MakerSeldon/SimpleOpenVentilator/System/ElectoMechanicalControlSystem/README.md

## **Electromechanical Control systems**

The System is driven by a very simple control system.

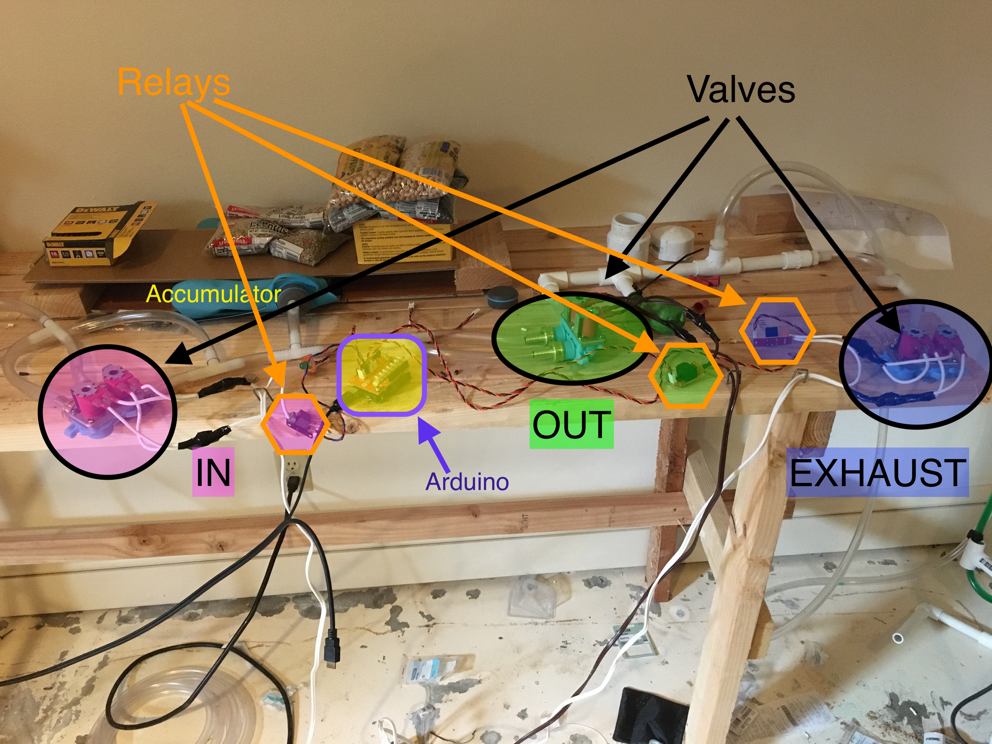
[picture p4: System/ElectoMechanicalControlSystem/AsBuilt.jpg]
As Built


### Mechanical
3 Valves

### Electrical
1 arudino uno
3 relays

---------------

### Current State:
Control circuit timing is fixed currently. Can be changed by uploading new code with updated constants

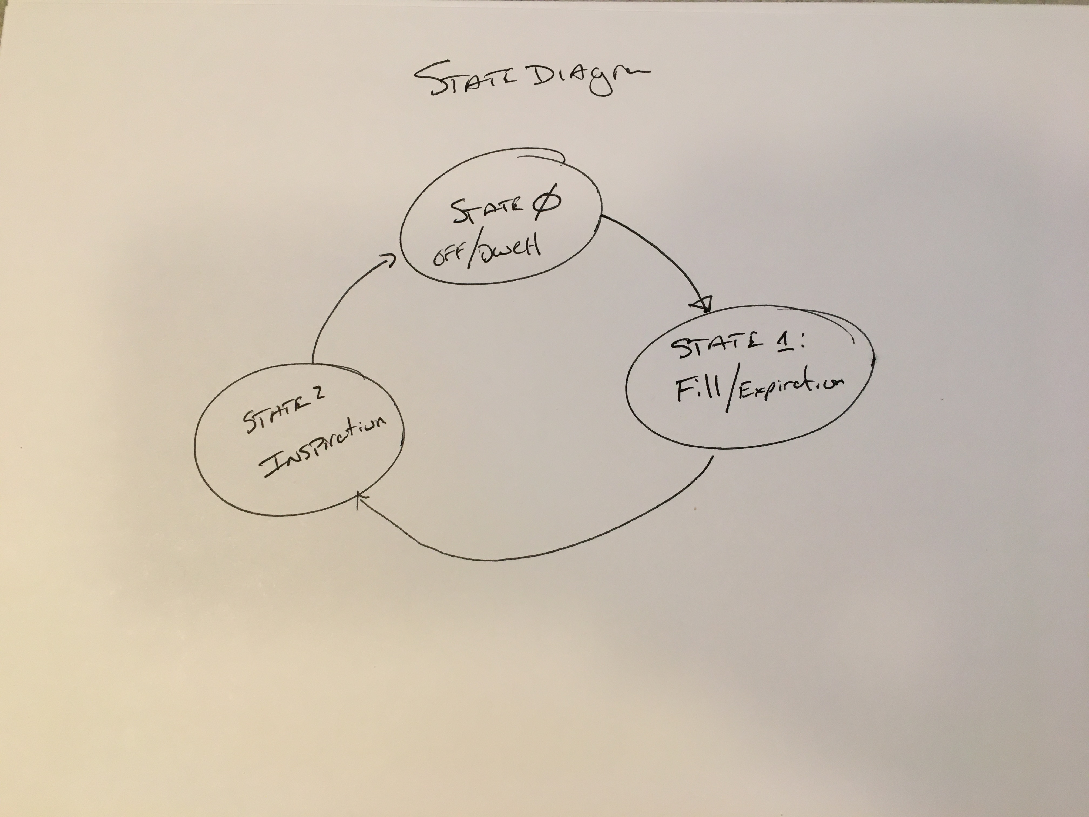
[picture p5: System/ElectoMechanicalControlSystem/StateDiagram.jpg]
State Diagram


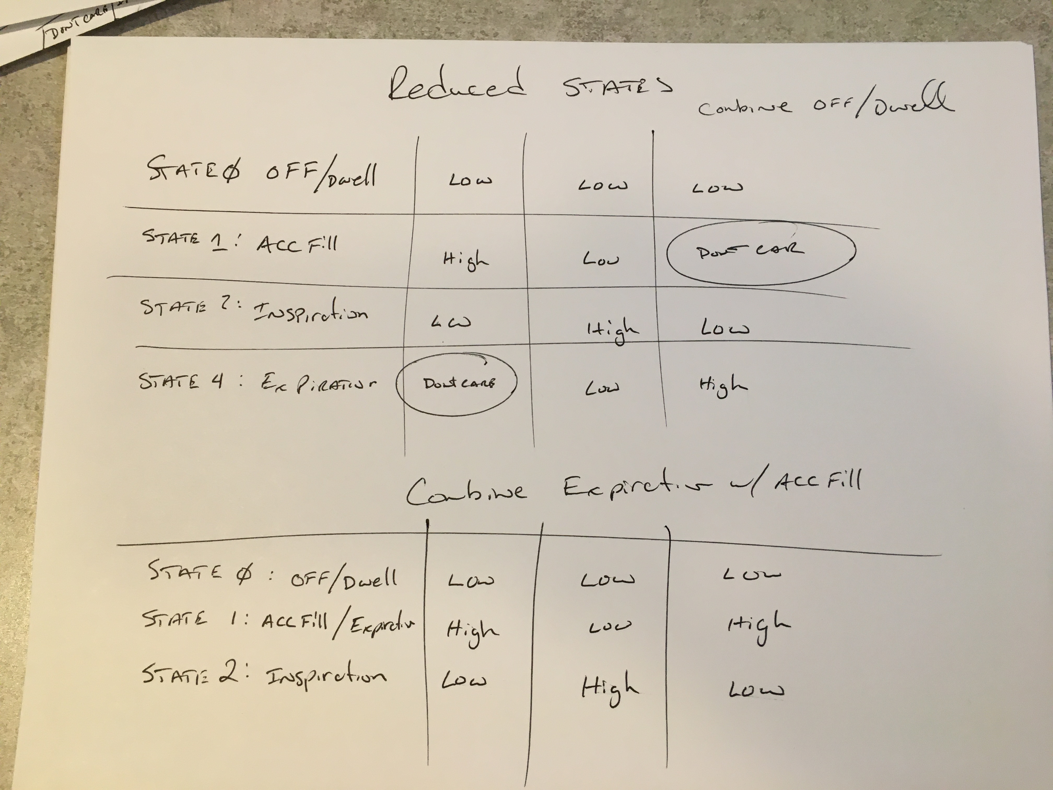
[picture p6: System/ElectoMechanicalControlSystem/Refined_page2.jpg]
State Variable Chart


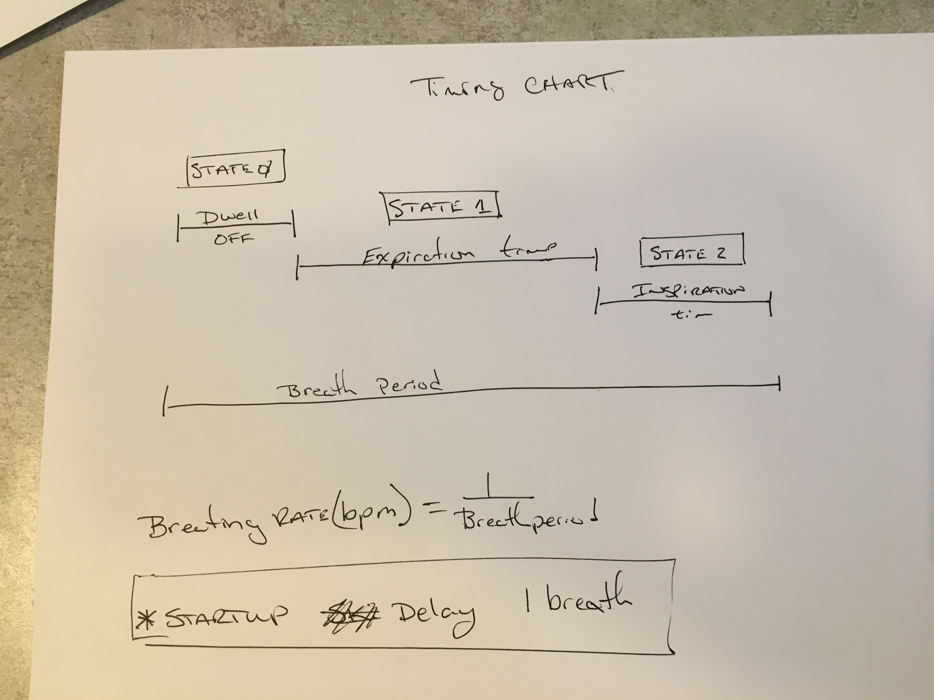
[picture p7: System/ElectoMechanicalControlSystem/TimingChart.jpg]
Timing Chart


### TODO:

* Add 2 Potentiometer inputs to vary Pulse width and Period
* Add display showing timing for each
* Add safety stops for out of bounds
