MakerSeldon/SimpleOpenVentilator/System/AirDistrubution/README.md

## Air Distribution

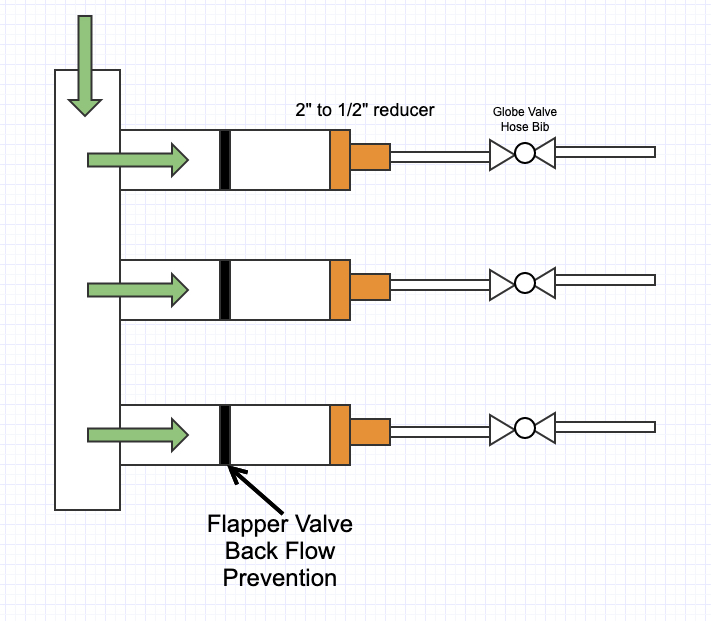
[picture p8: System/AirDistrubution/AirDistribution.jpg]
Distribution


**TODO: Pictures,Assembly Instructions**
