MakerSeldon/SimpleOpenVentilator/System/AmbuBag/README.md

## Ambu+ Bag

An Ambu+ bag or equivalent is a human powered ventilator. The device has multiple
safety features, valves, volume, and pressure check in it. Below is a drawing
of one reverse engineered. This was from the one we had in lab.

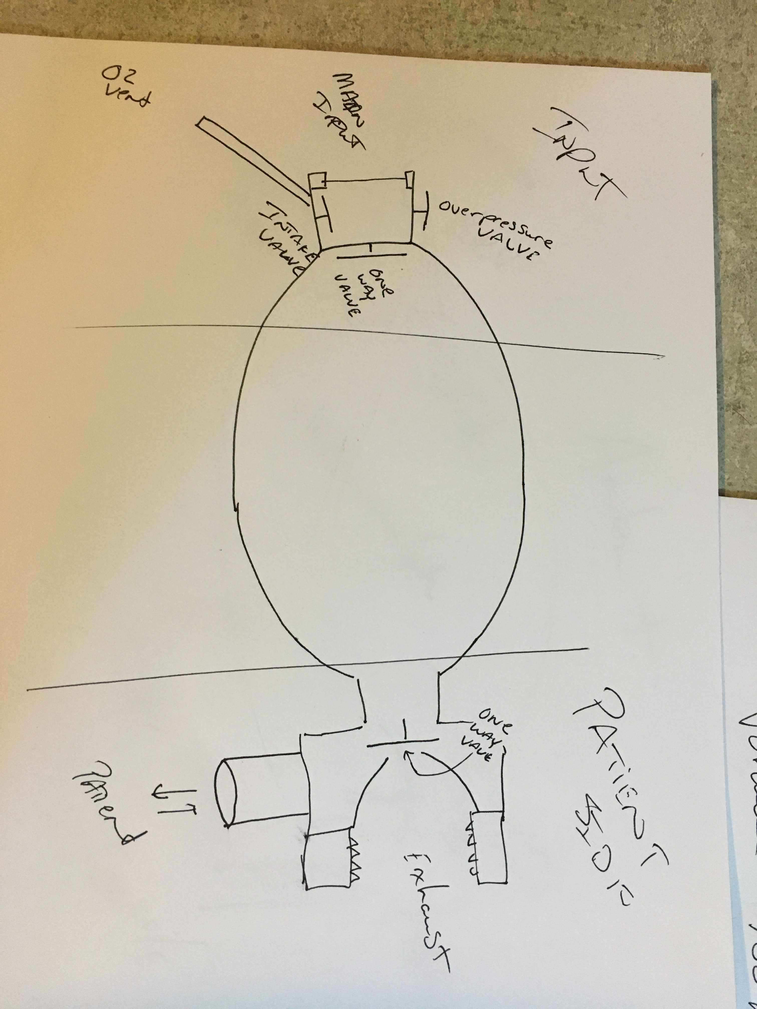
[picture p14: System/AmbuBag/ambubagdrawing.jpg]
AmbuBag
