MakerSeldon/SimpleOpenVentilator/System/LowPressureManometer/README.md

## Low Pressure Manometer

Having a means of reliably measuring pressure is critical to the performance of any ventilator. The readily available pressure gauges are typically designed for tire pressures 15-100psi. We are concerned with slightly negative pressure or slightly positive. The medical field measures in mmHg. We don't have that readily available, but we do have water available.

### Design Drawing
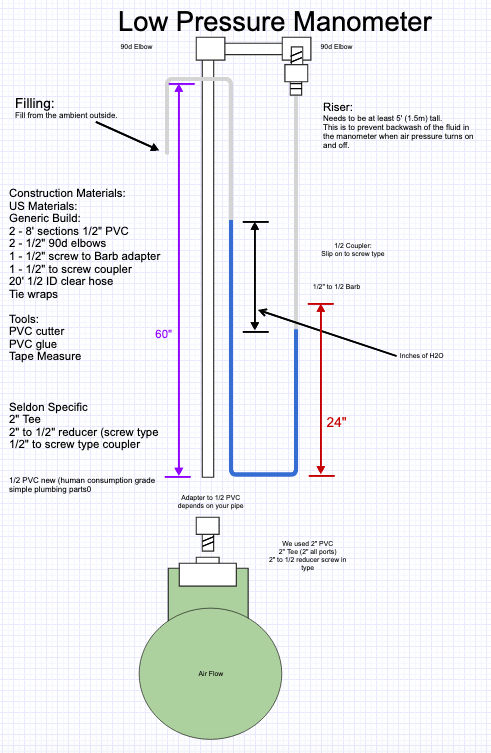
[picture p15: System/LowPressureManometer/manometerDrawing3.jpg]
Simplified


### Images
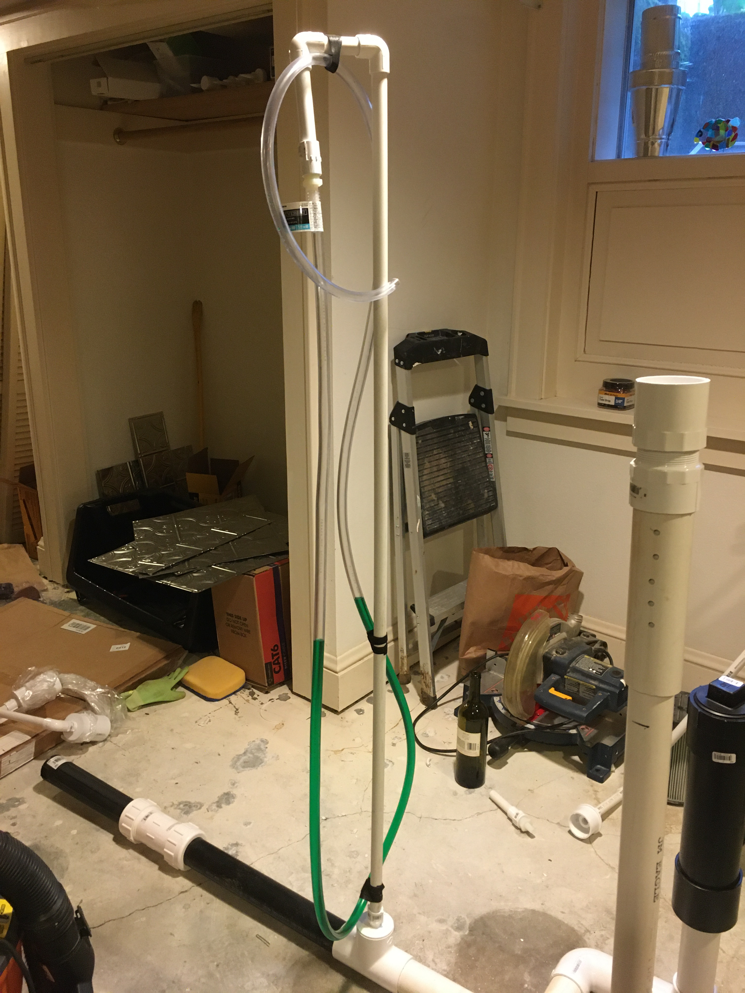
[picture p16: System/LowPressureManometer/ManometerSide.jpg]
Side View Green Food Coloring

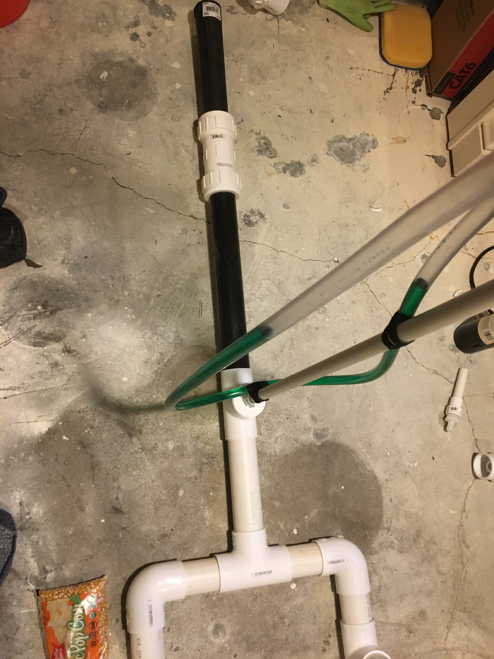
[picture p17: System/LowPressureManometer/ManometerConnect.jpg]
How to connect

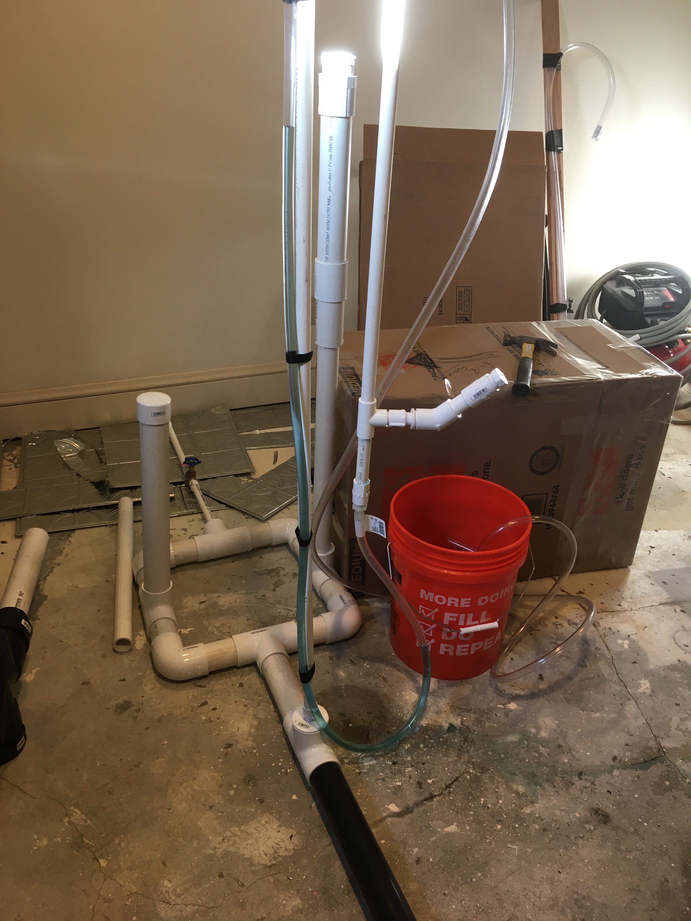
[picture p18: System/LowPressureManometer/manometer_success.jpg]
Working Manometer

Measured 39" of pressure..

### Lessons Learned
It is relatively easy to make a manometer, clear tubing and some water, but as I learned keeping the water out of the flow and in the tube is easy, but takes a bit of ingenuity. Mostly it just takes height.
