MakerSeldon/SimpleOpenVentilator/System/PressureRelief/README.md

## Pressure Relief Valve
Basic gravity pressure relief valve. When overpressure occurs, the lid tilts knocking the weight off and opening the line to ambient air. Valve tilted at a 10degree angle to ensure proper operation.

**TODO: Document and Test**

### Version 2
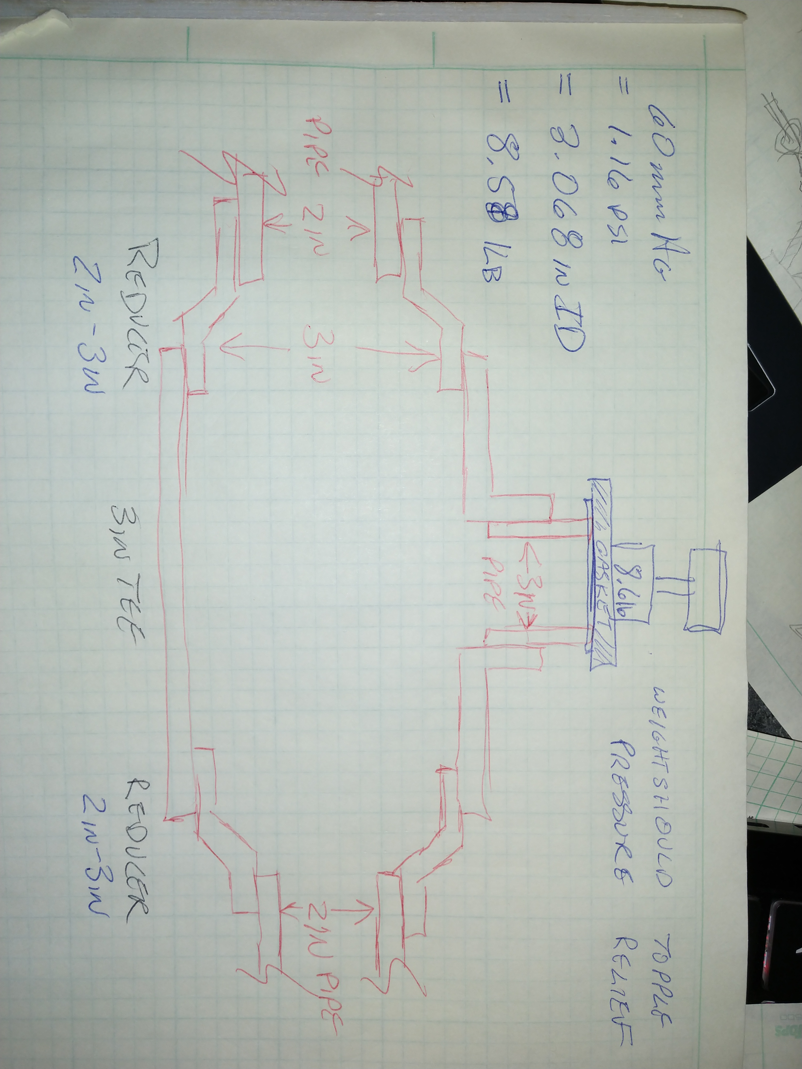
[picture p21: System/RawDesigns/PRV_sketch.jpg]
As Sketched

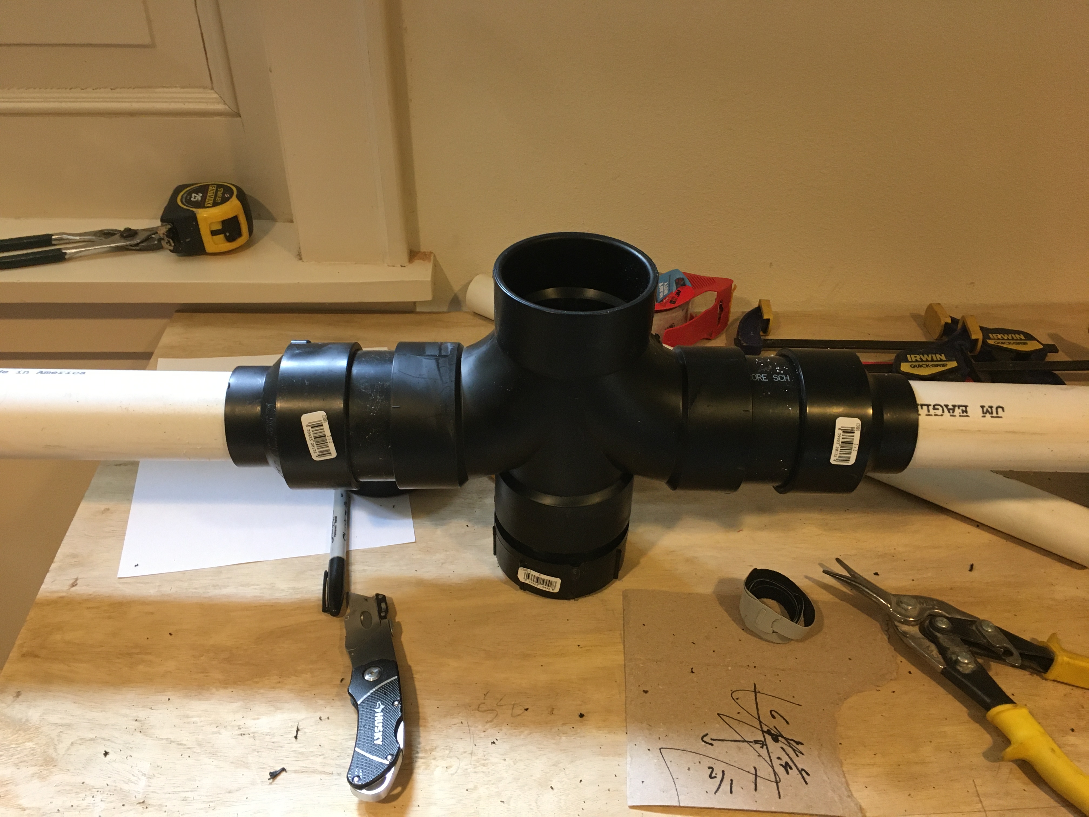
[picture p22: System/Images/PRV_built.jpg]
As Built


### Version 1
OBE
