MakerSeldon/SimpleOpenVentilator/System/AirDistrubution/BackflowValve/README.md

### Backflow Control Valve

Description from ____

Ping pong ball 1.57" diameter
Upward facing 2" to 1.5" reducer (funnel shaped)

1.5" section of pipe
2.0" section of pipe
reduce down to 1/2" for hose bib

Note: This is gravity and has to face up so the ball rolls into the pipe
