MakerSeldon/SimpleOpenVentilator/System/AirFilter/v1/README.md

# Experiment 1:
Can we build a box that can filter the air from a shop vac from Home Depot
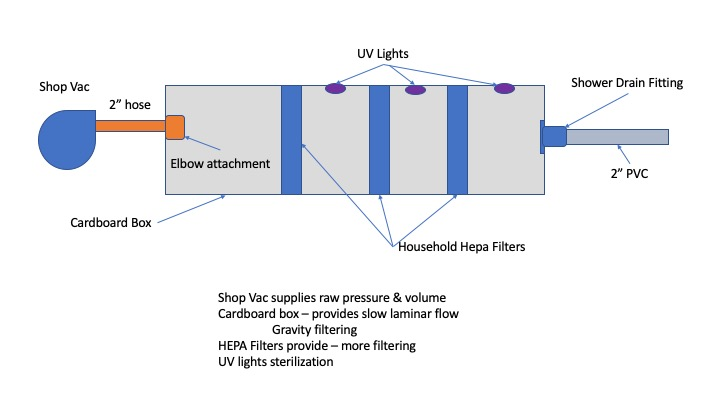
[picture p26: System/AirFilter/v1/AirflowBox.jpg]
Airflow Box

---------
# Hypothesis 1:
We can build a box that will provide laminar flow through the volume so gravity can filter larger particles, and HEPA / nice filters can do the job

## Build - 1
Single Stage Filter box

Shop vac input -- box -- 16x20x4 filter -- box -- 2" output
* AirBoxExperiment_1.jpg shows supplies used
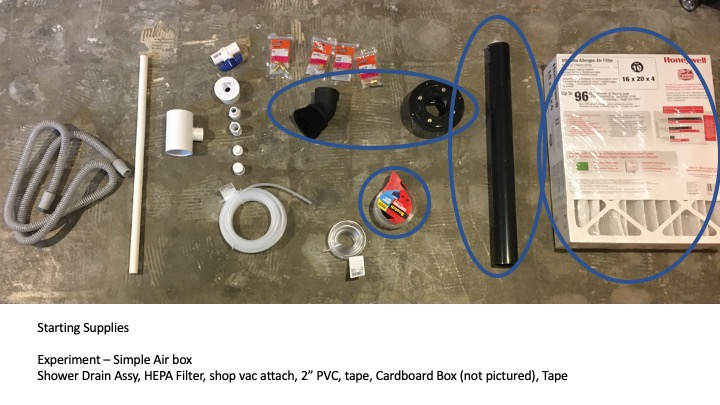
[picture p27: System/AirFilter/v1/AirBoxExperiment_1.jpg]
Parts used
  
* FilterInstall.jpg shows putting the filter in the middle of two boxes
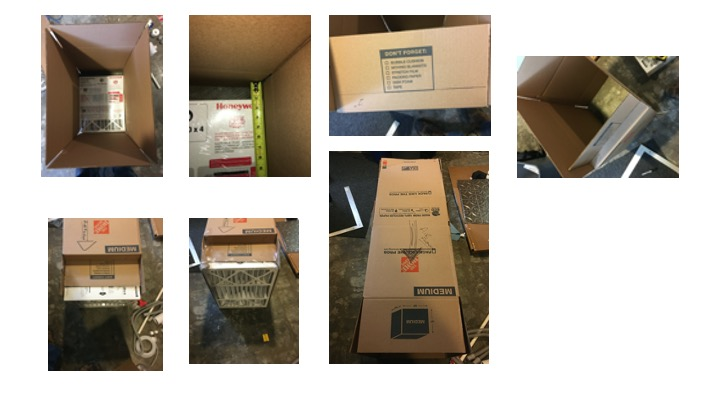
[picture p28: System/AirFilter/v1/FilterInstall.jpg]
Installing the filter
  
* Input/Output.jpg shows installing the in/out fittings.
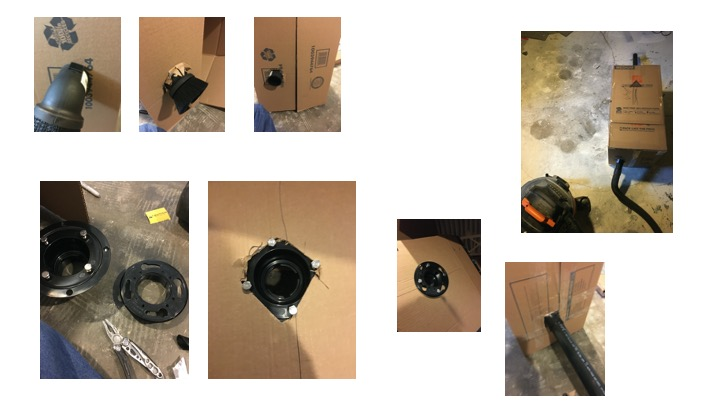
[picture p29: System/AirFilter/v1/InputOutput.jpg]
Final Assembly of single stage
  

Functionally tested system Air blows through fine -- no significant pitch change in shop vac. Shop vac has filter and bag installed.

# Hypothesis 2:
Shop Vac can push enough air through filter-box without loading the vac significantly.
## Results:
* Initial results positive, not change in sound from shop vac.
* TODO: measure pressure drop across box.
* Initial output pressure 0.5"water on the manometer
* Tested direct output of ShopVac Blew water out 3' 5/8ID hose

# RESULTS: **NEGATIVE** Box leaked way too much air.  Need to try again with a crate

## Build - 2
Build simple manometer for input and output
