MakerSeldon/SimpleOpenVentilator/System/Diagrams/README.md

## Adding and testing clarity of diagrams

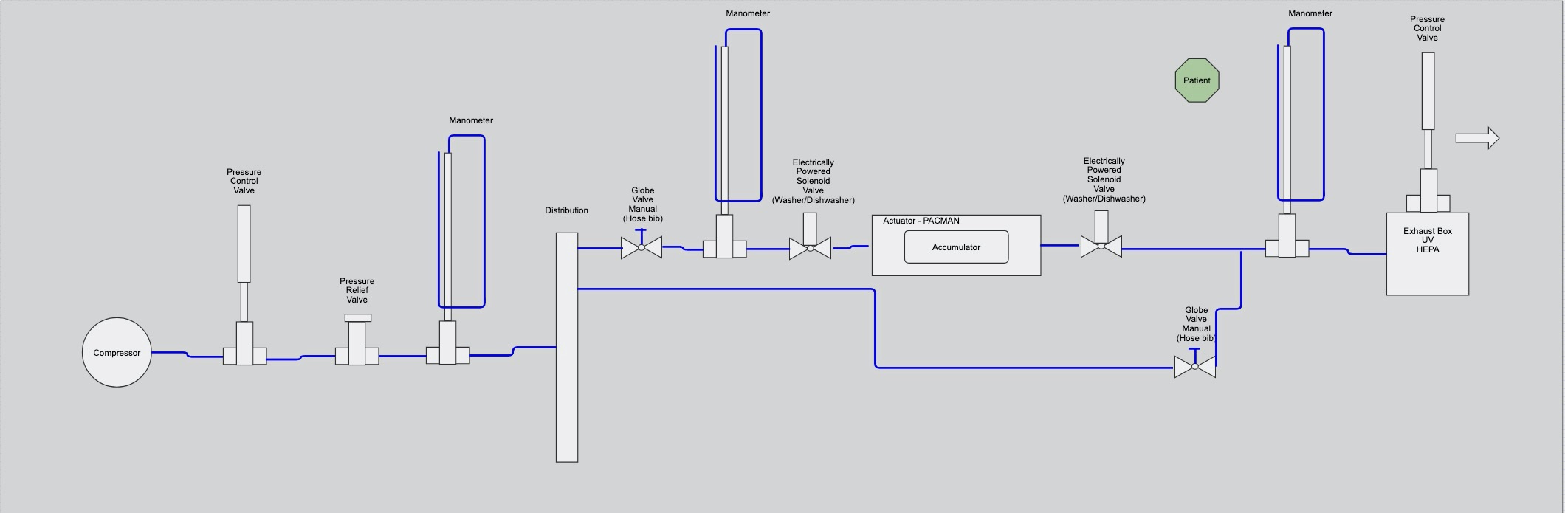
[picture p32: System/Diagrams/PipeView.jpg]
Diagram 1

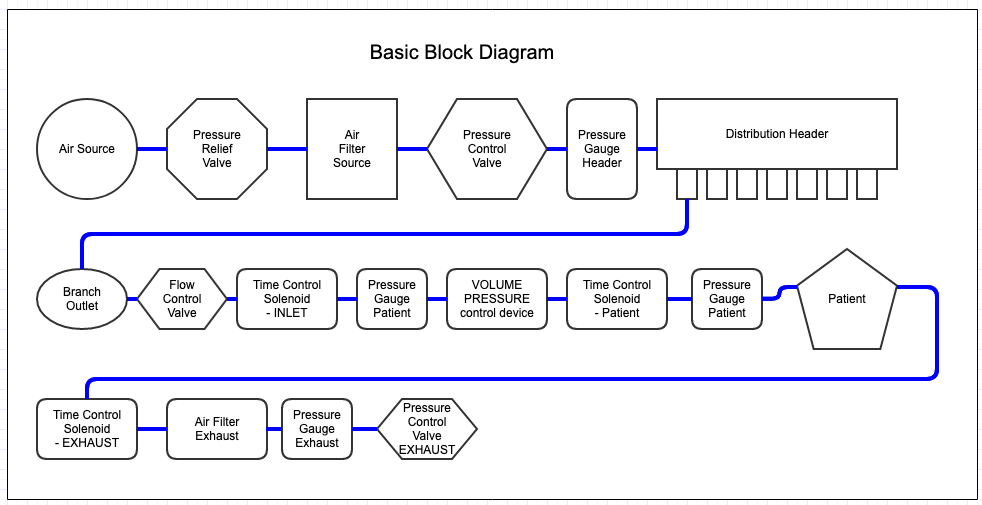
[picture p33: System/Diagrams/BlockDiagramv1.1.png]
Block Diagram

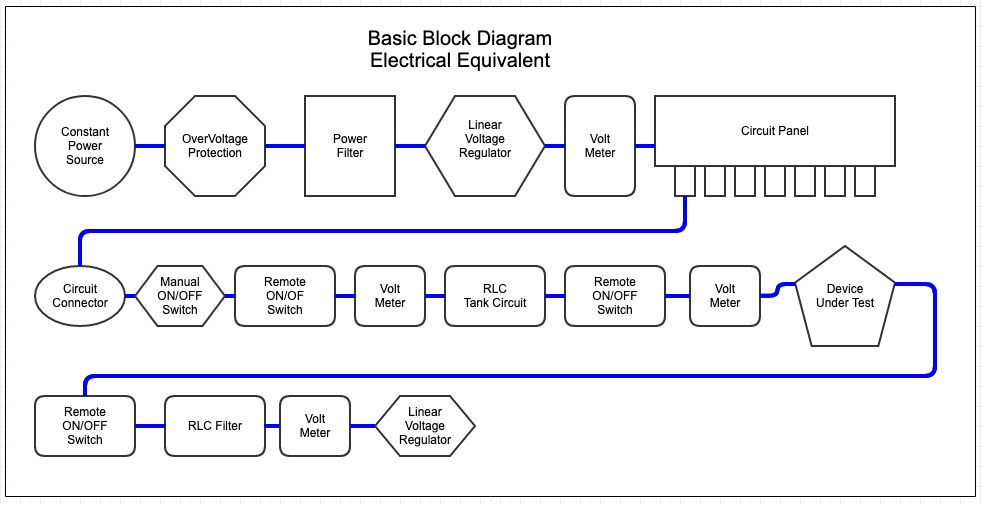
[picture p34: System/Diagrams/EEequivalent.jpg]
EE Equivalent
