MakerSeldon/SimpleOpenVentilator/System/AirFilter/v1/FlowDiagramv1.jpg

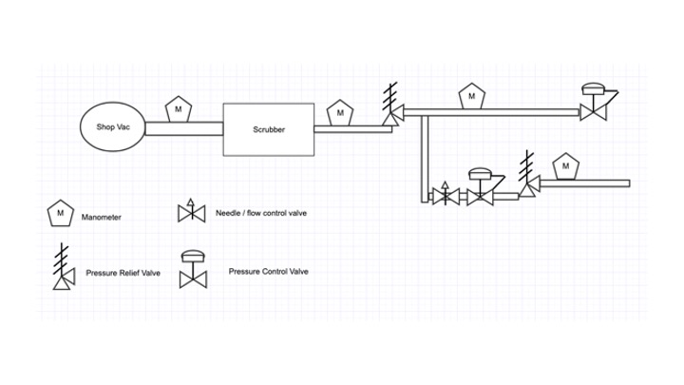
System/AirFilter/v1/FlowDiagramv1.jpg
