MakerSeldon/SimpleOpenVentilator/System/ElectoMechanicalControlSystem/RawStateDiagram.jpg

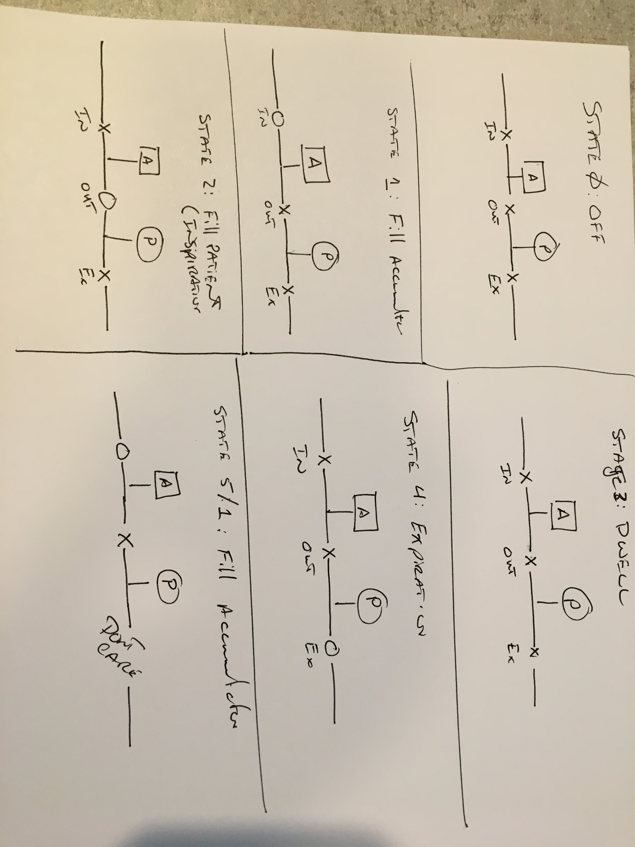
System/ElectoMechanicalControlSystem/RawStateDiagram.jpg
