MakerSeldon/SimpleOpenVentilator/System/ElectoMechanicalControlSystem/Refined_page1.jpg

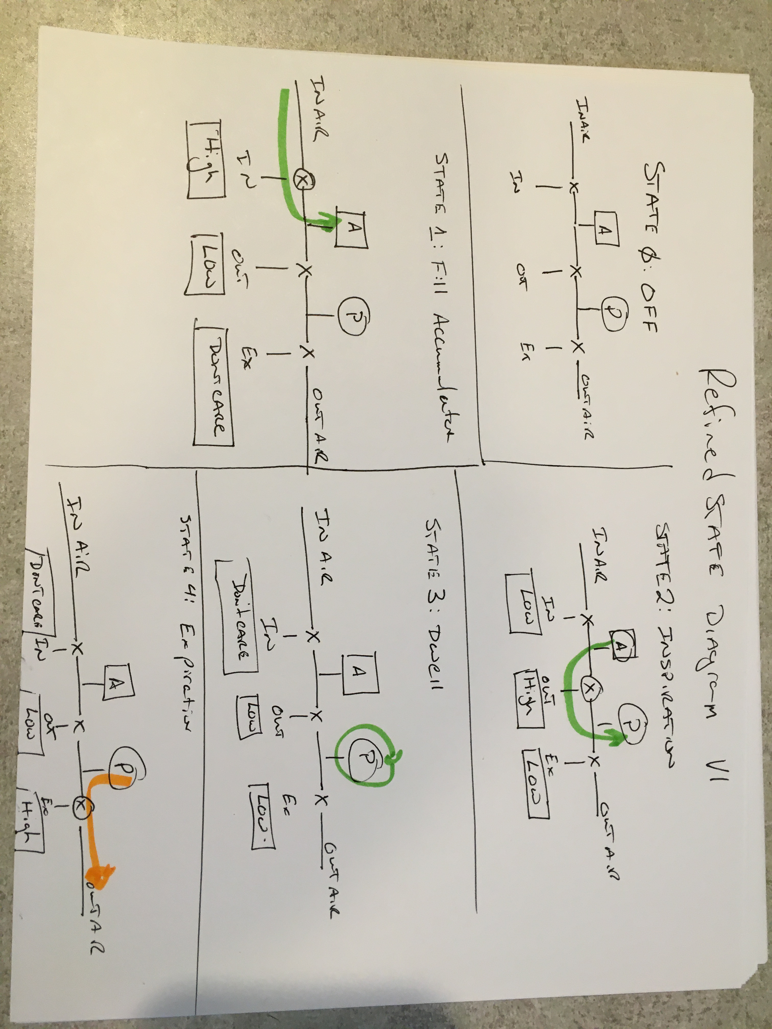
System/ElectoMechanicalControlSystem/Refined_page1.jpg
