MakerSeldon/SimpleOpenVentilator/System/Images/AlternativeTop.JPG

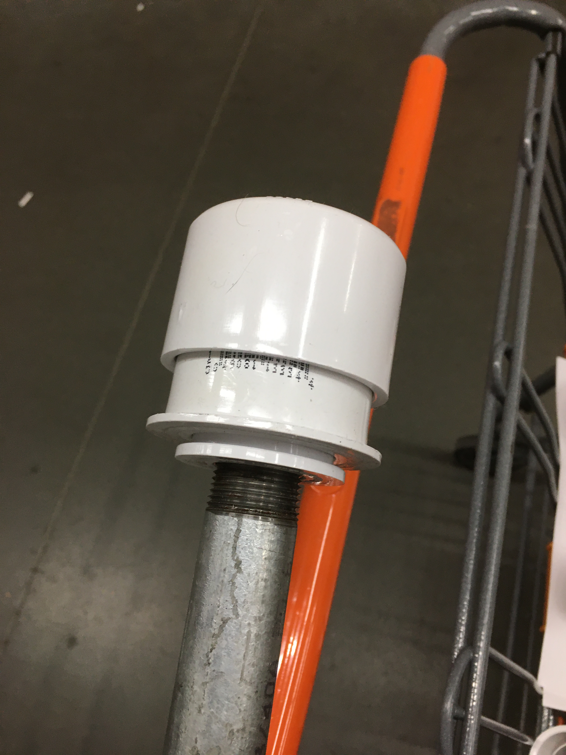
System/Images/AlternativeTop.JPG
