MakerSeldon/SimpleOpenVentilator/System/Images/ConceptDiagram.png

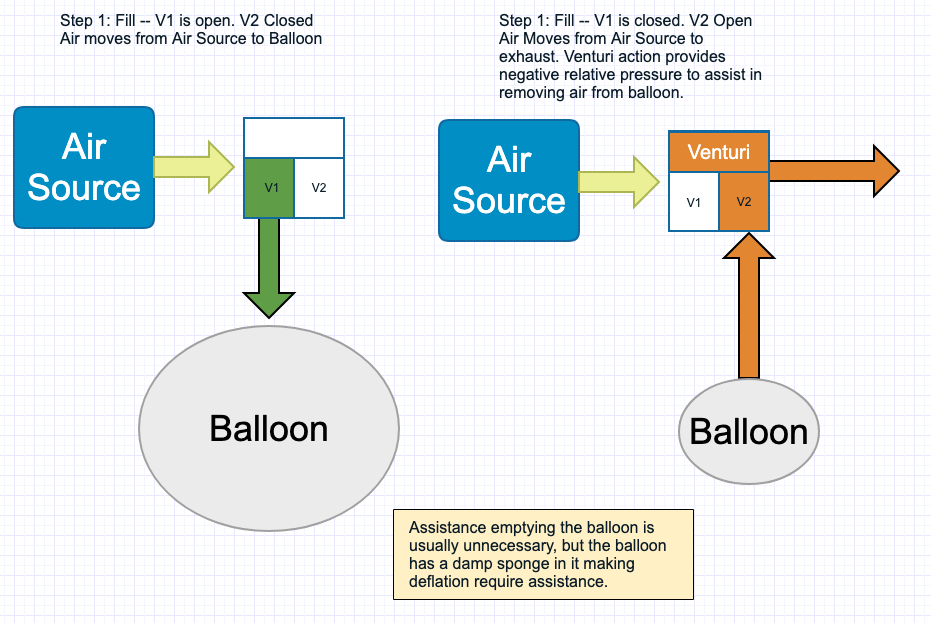
System/Images/ConceptDiagram.png
