MakerSeldon/SimpleOpenVentilator/System/Images/dualStantions.JPG

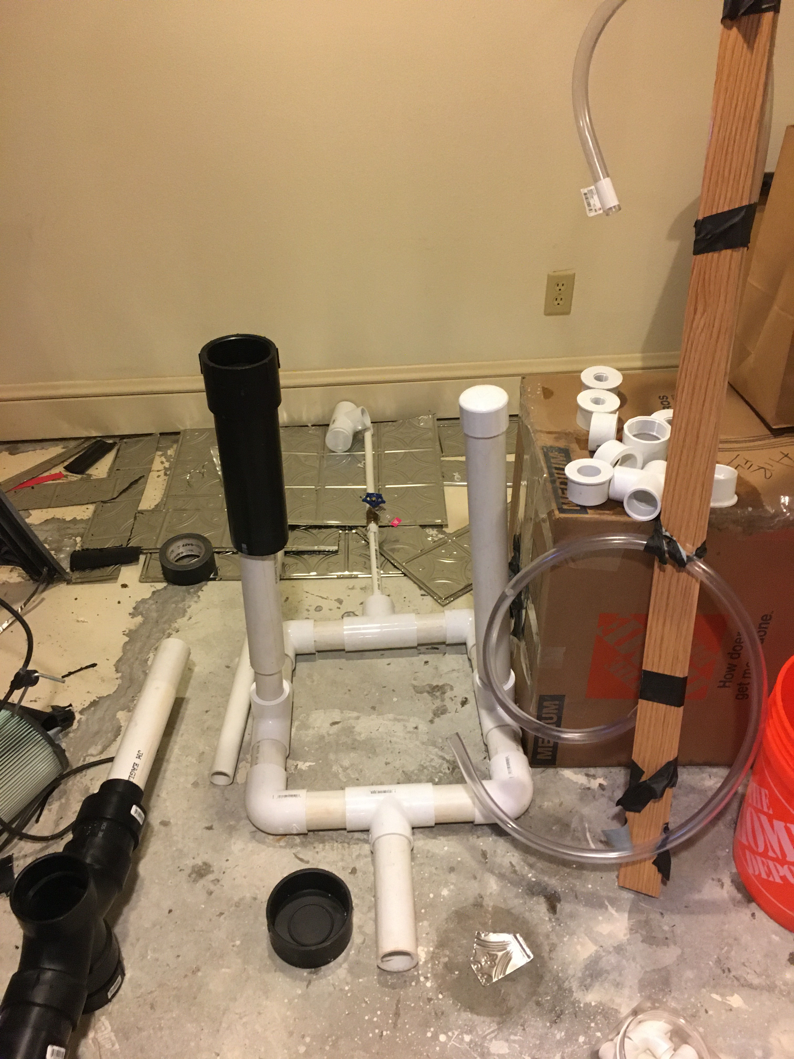
System/Images/dualStantions.JPG
