MakerSeldon/SimpleOpenVentilator/System/Images/IMG_0153.JPG

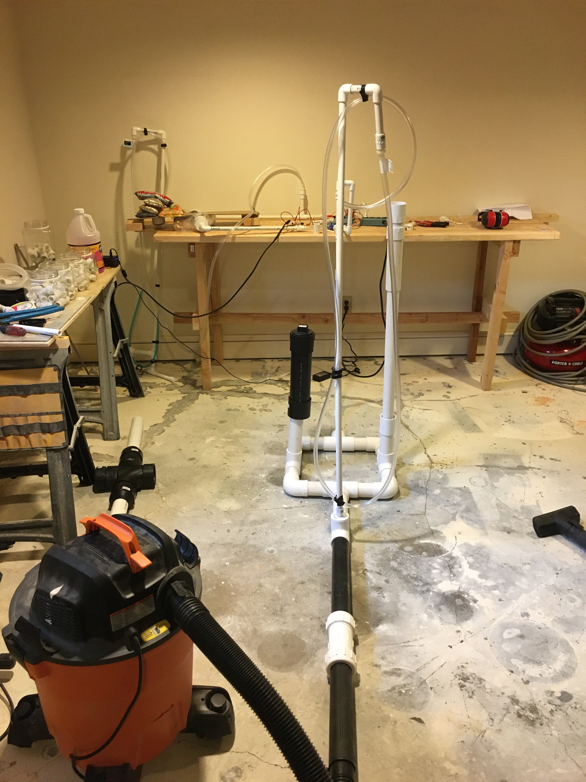
System/Images/IMG_0153.JPG
