MakerSeldon/SimpleOpenVentilator/System/Images/IMG_0154.JPG

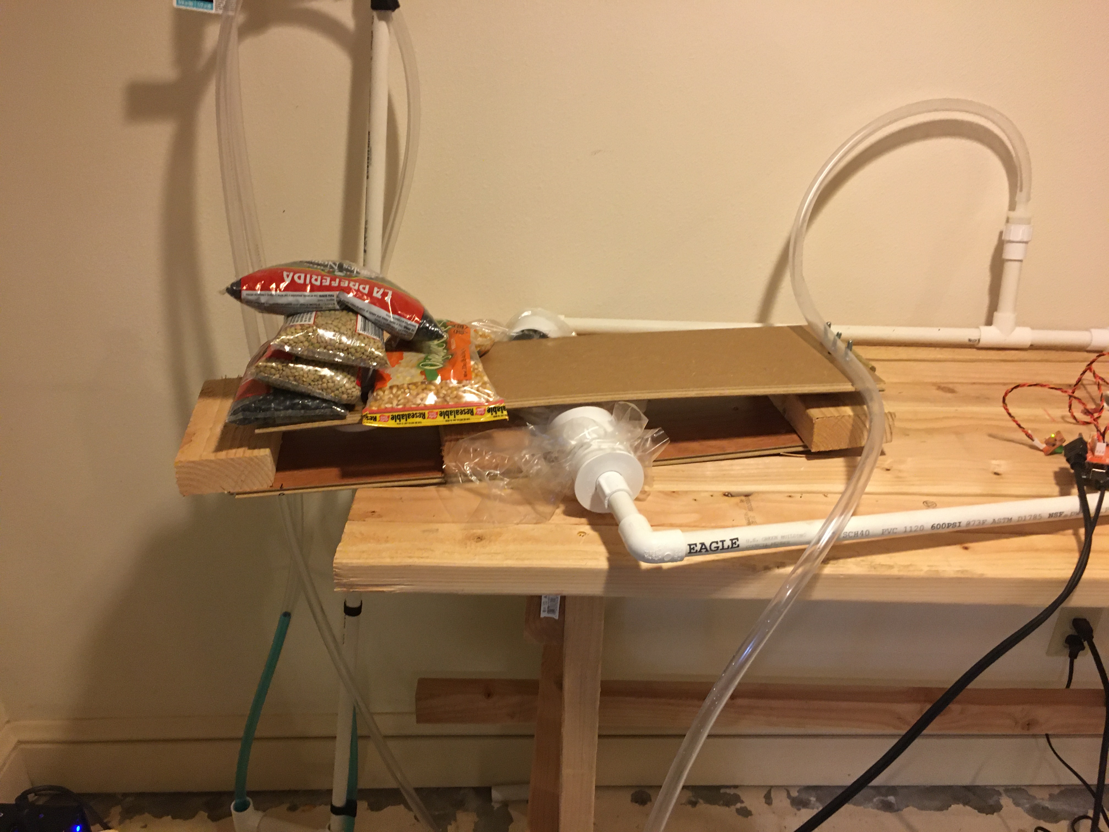
System/Images/IMG_0154.JPG
