MakerSeldon/SimpleOpenVentilator/System/Images/IMG_0155.JPG

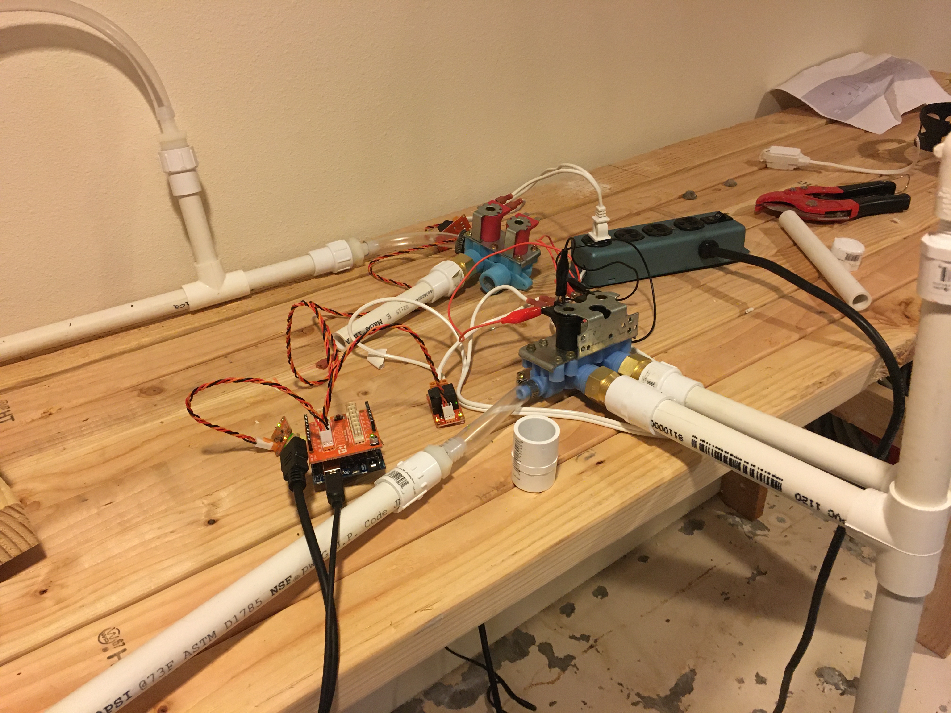
System/Images/IMG_0155.JPG
