MakerSeldon/SimpleOpenVentilator/System/Images/IMG_0156.JPG

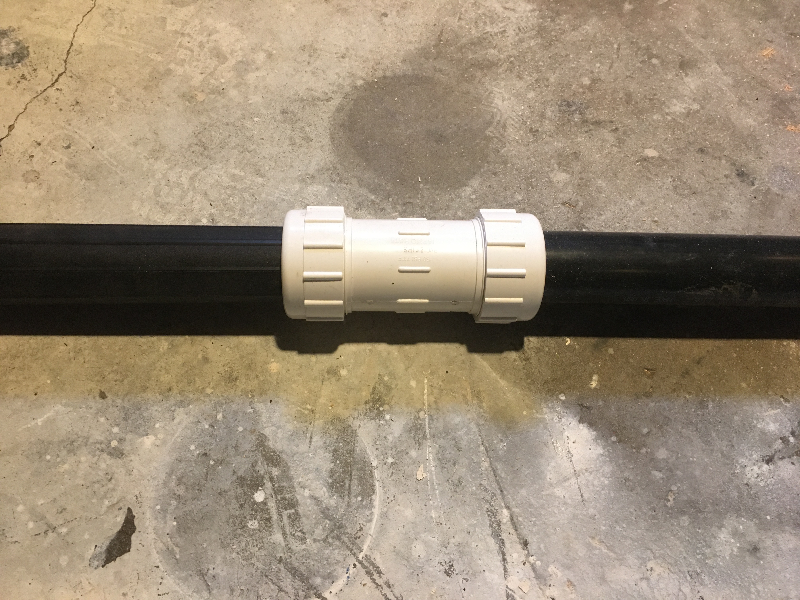
System/Images/IMG_0156.JPG
