MakerSeldon/SimpleOpenVentilator/System/Images/IMG_0164.JPG

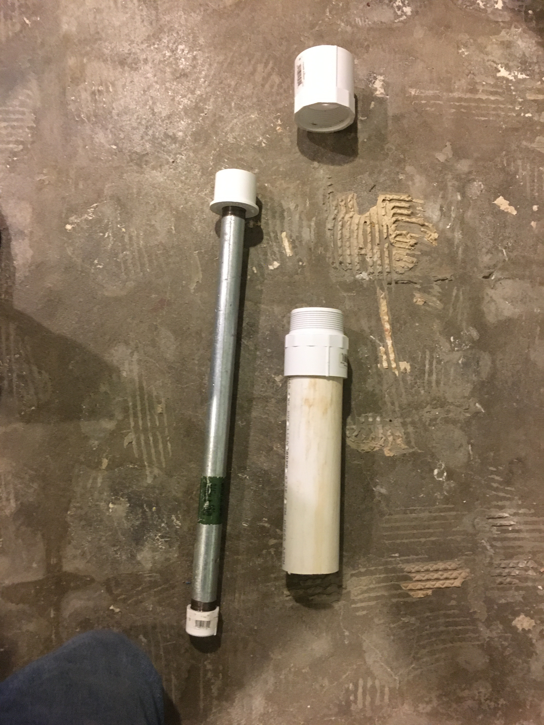
System/Images/IMG_0164.JPG
