MakerSeldon/SimpleOpenVentilator/System/Images/IMG_0168.JPG

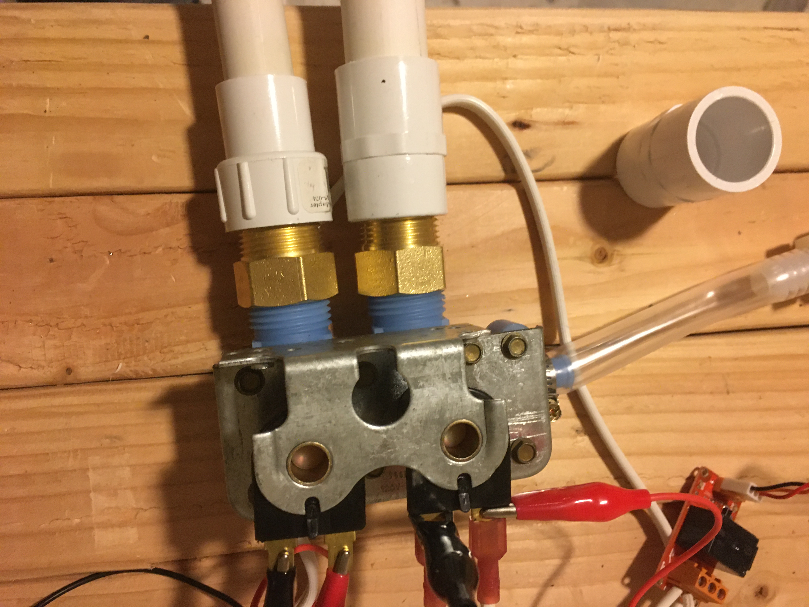
System/Images/IMG_0168.JPG
