MakerSeldon/SimpleOpenVentilator/System/Images/IMG_0169.JPG

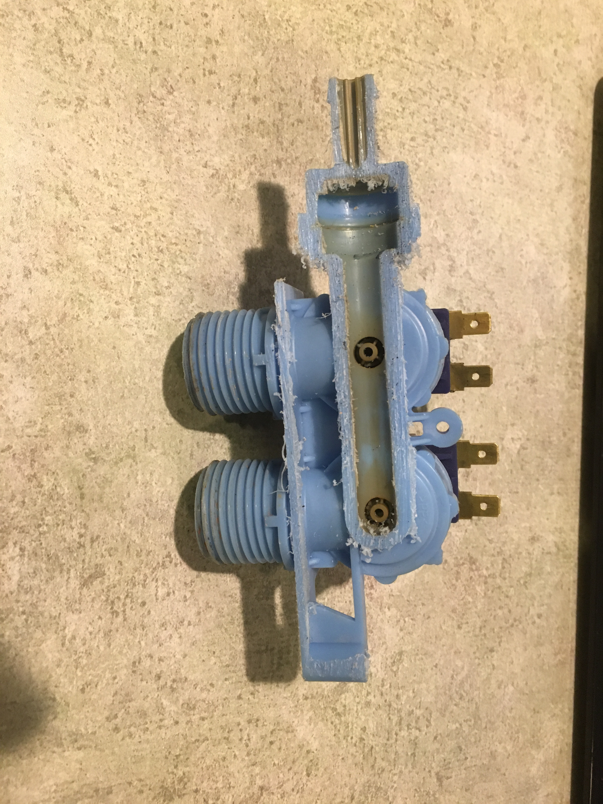
System/Images/IMG_0169.JPG
