MakerSeldon/SimpleOpenVentilator/System/Images/IMG_0170.JPG

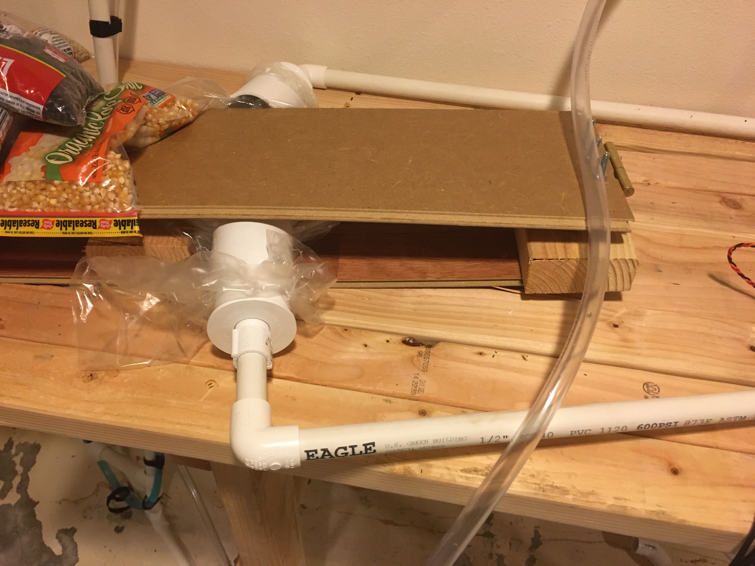
System/Images/IMG_0170.JPG
