MakerSeldon/SimpleOpenVentilator/System/Images/IMG_0171.JPG

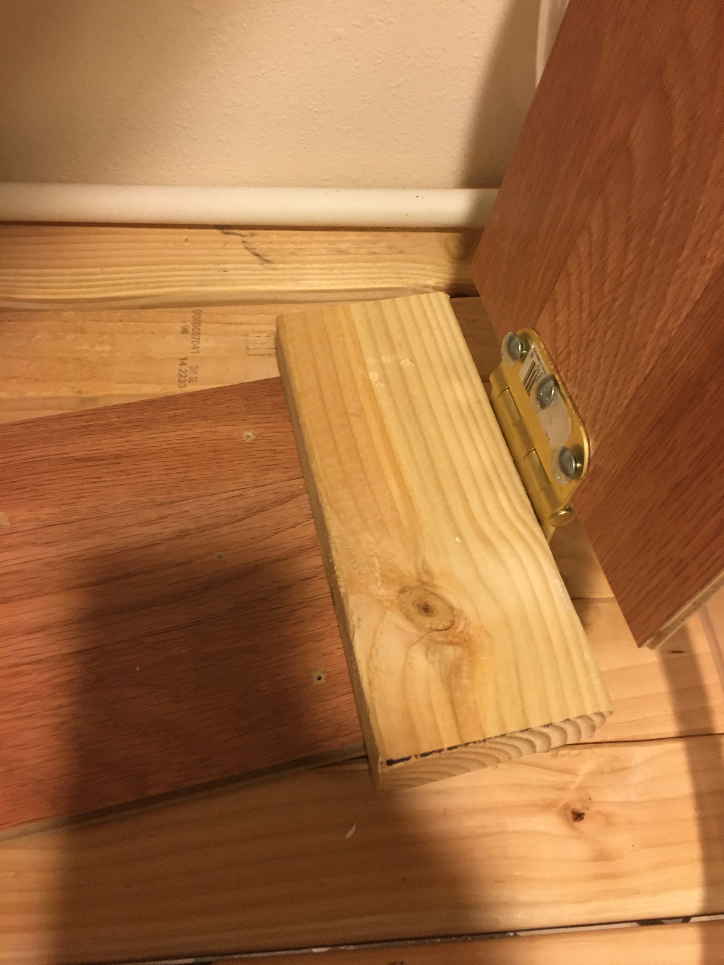
System/Images/IMG_0171.JPG
