MakerSeldon/SimpleOpenVentilator/System/Images/IMG_0172.JPG

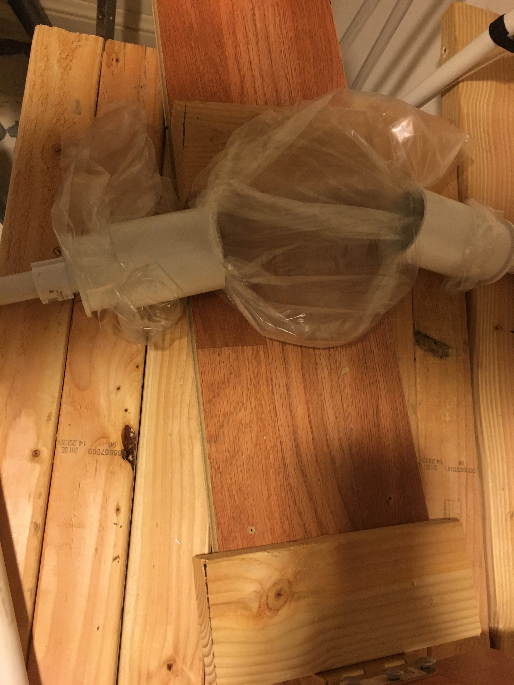
System/Images/IMG_0172.JPG
