MakerSeldon/SimpleOpenVentilator/System/Images/manometer0.JPG

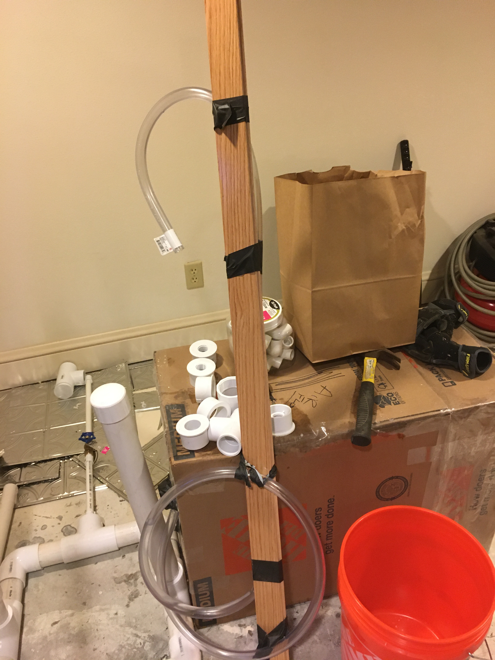
System/Images/manometer0.JPG
