MakerSeldon/SimpleOpenVentilator/System/Images/pipewieghtparts.JPG

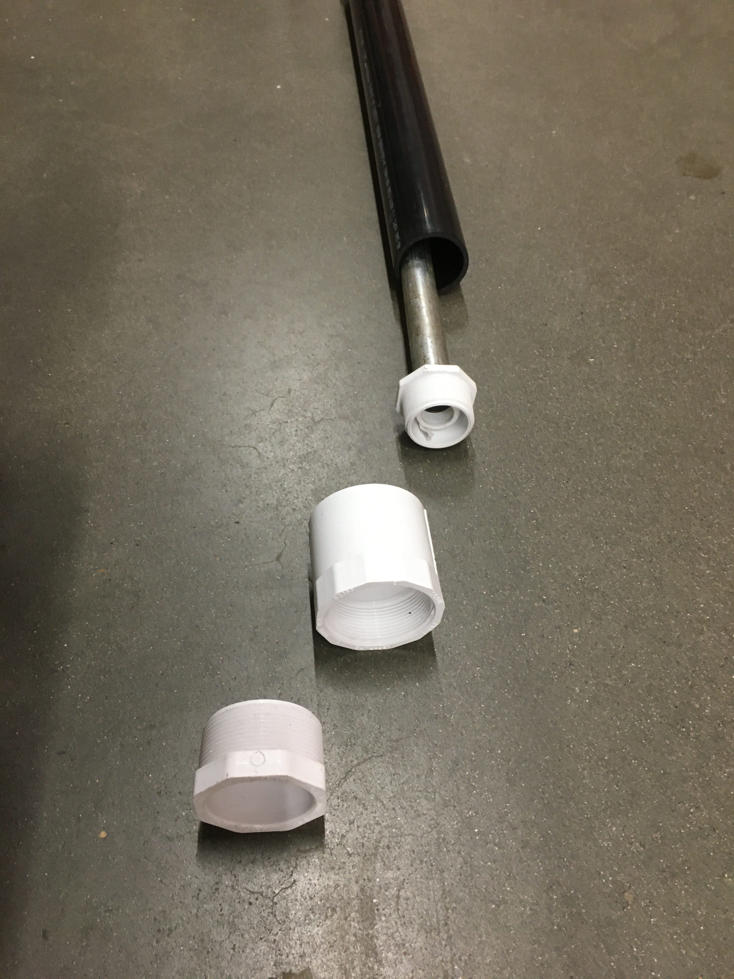
System/Images/pipewieghtparts.JPG
