MakerSeldon/SimpleOpenVentilator/System/Images/Progress24Mar.jpg

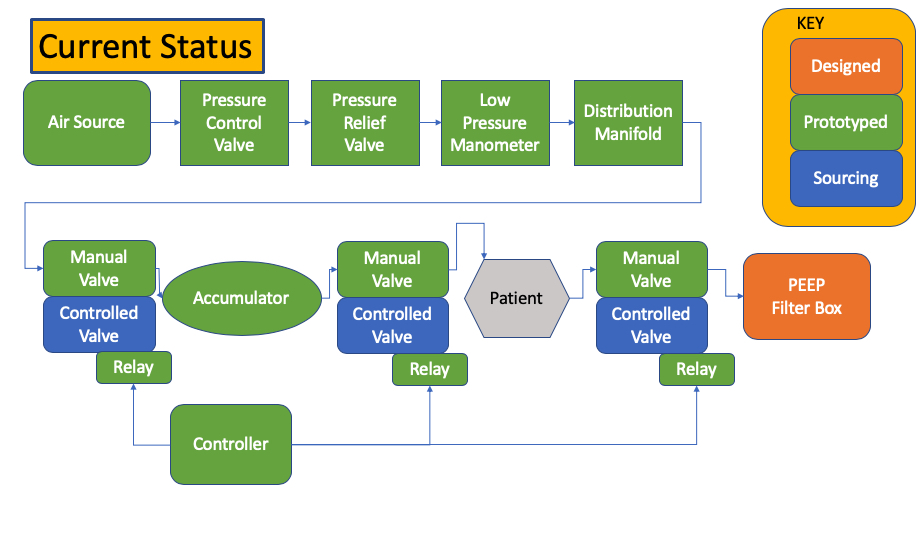
System/Images/Progress24Mar.jpg
