MakerSeldon/SimpleOpenVentilator/System/Images/relays.jpg

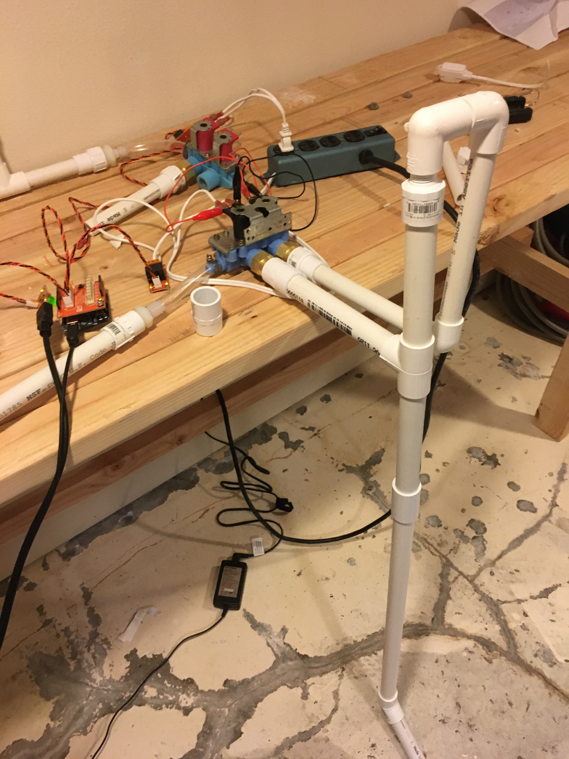
System/Images/relays.jpg
