MakerSeldon/SimpleOpenVentilator/System/Images/rig1.JPG

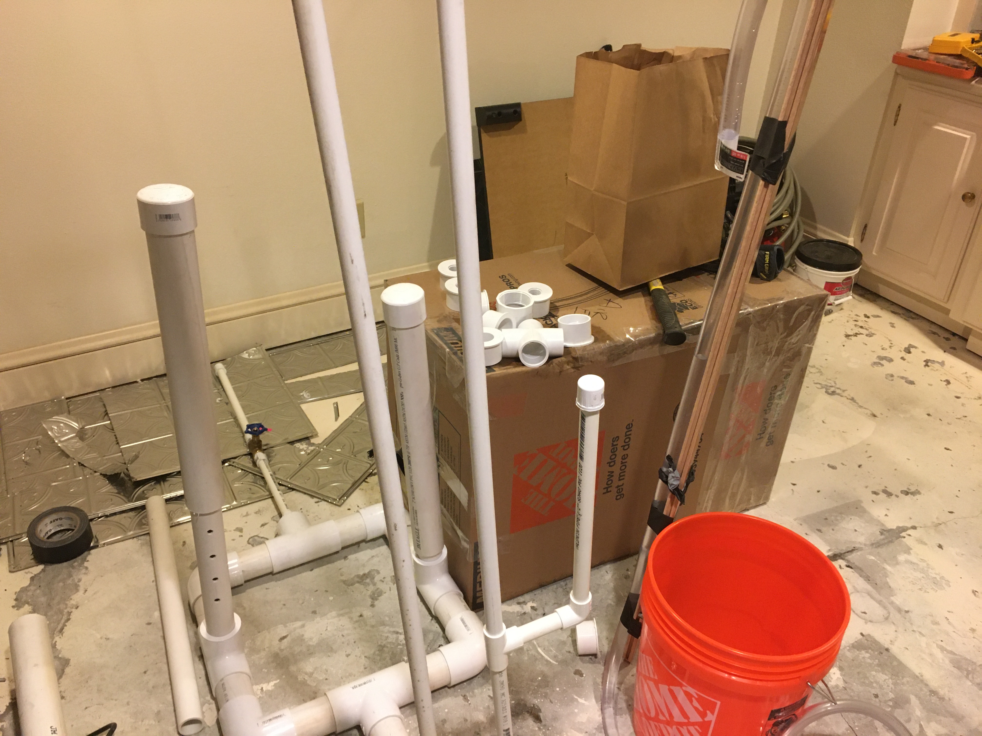
System/Images/rig1.JPG
