MakerSeldon/SimpleOpenVentilator/System/Images/Simple.jpg

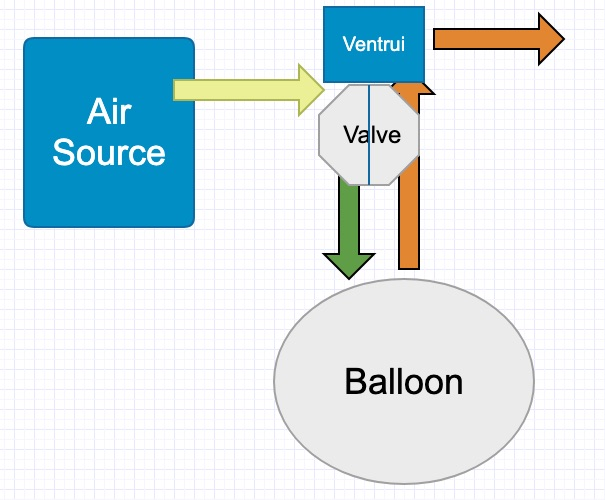
System/Images/Simple.jpg
