MakerSeldon/SimpleOpenVentilator/System/Images/SuccessManometer1.JPG

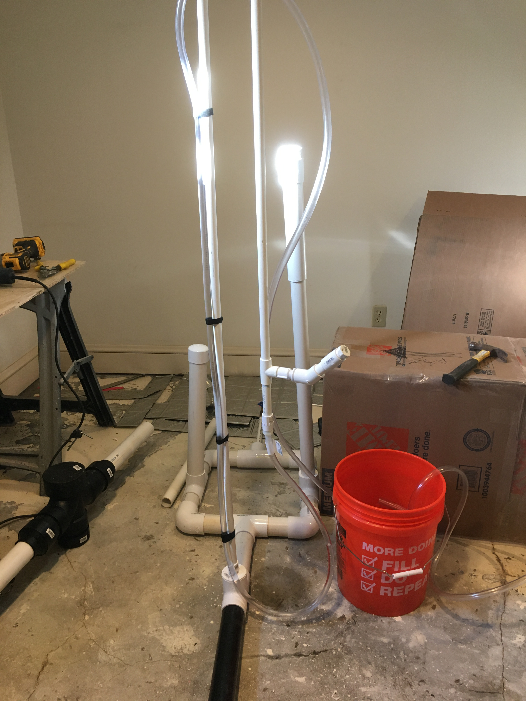
System/Images/SuccessManometer1.JPG
