MakerSeldon/SimpleOpenVentilator/System/Images/SystemBlockDiagram2.jpg

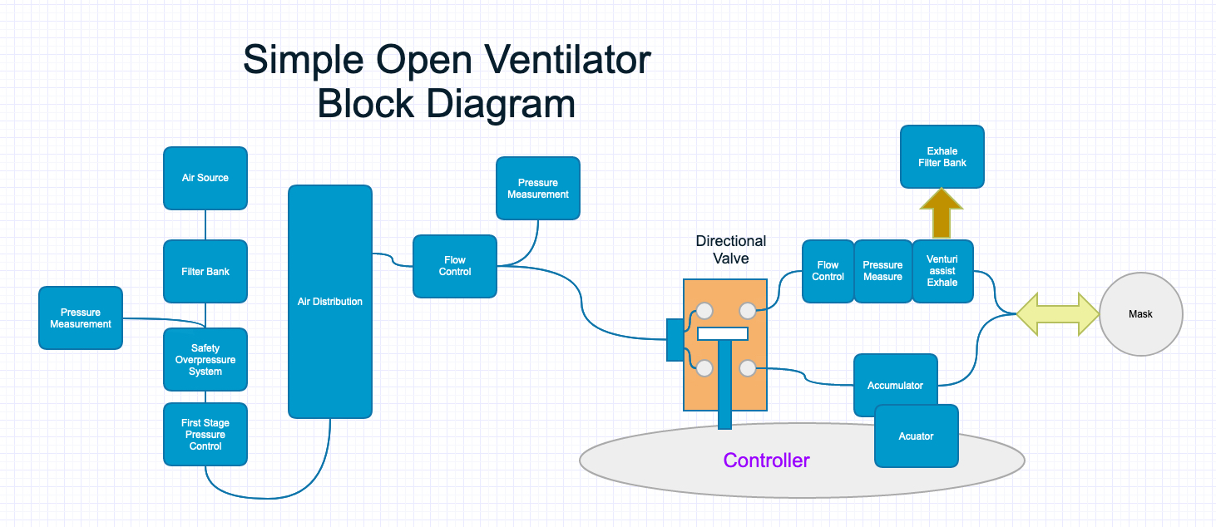
System/Images/SystemBlockDiagram2.jpg
