MakerSeldon/SimpleOpenVentilator/System/Images/SystemBlockDiagram3.jpg

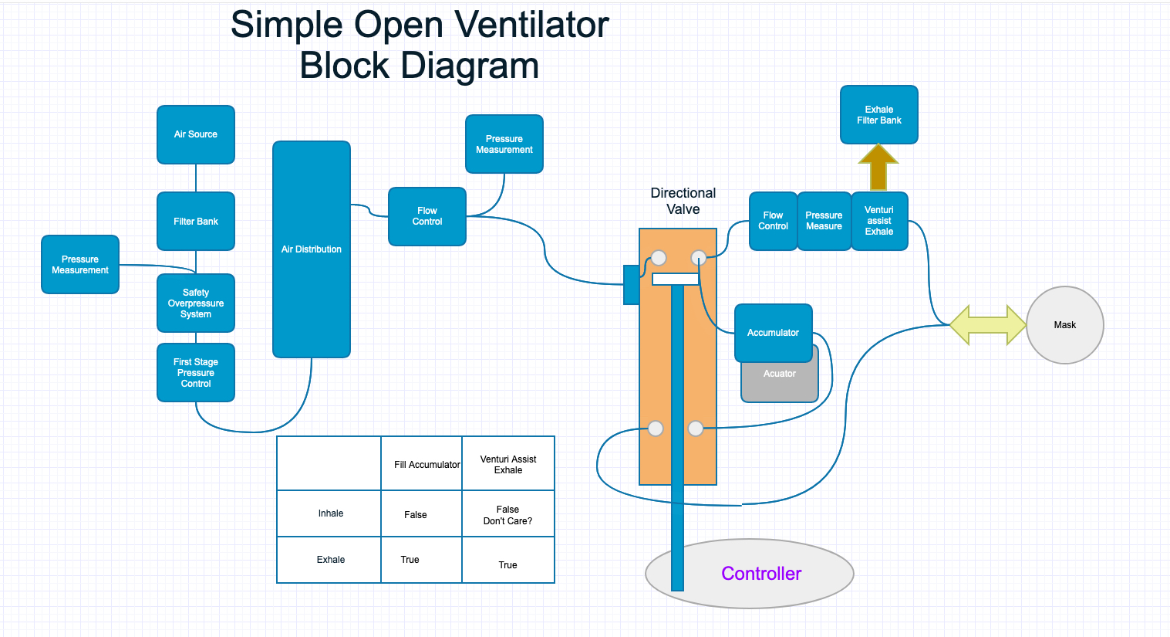
System/Images/SystemBlockDiagram3.jpg
