MakerSeldon/SimpleOpenVentilator/System/Images/SystemBlockDiagram.jpg

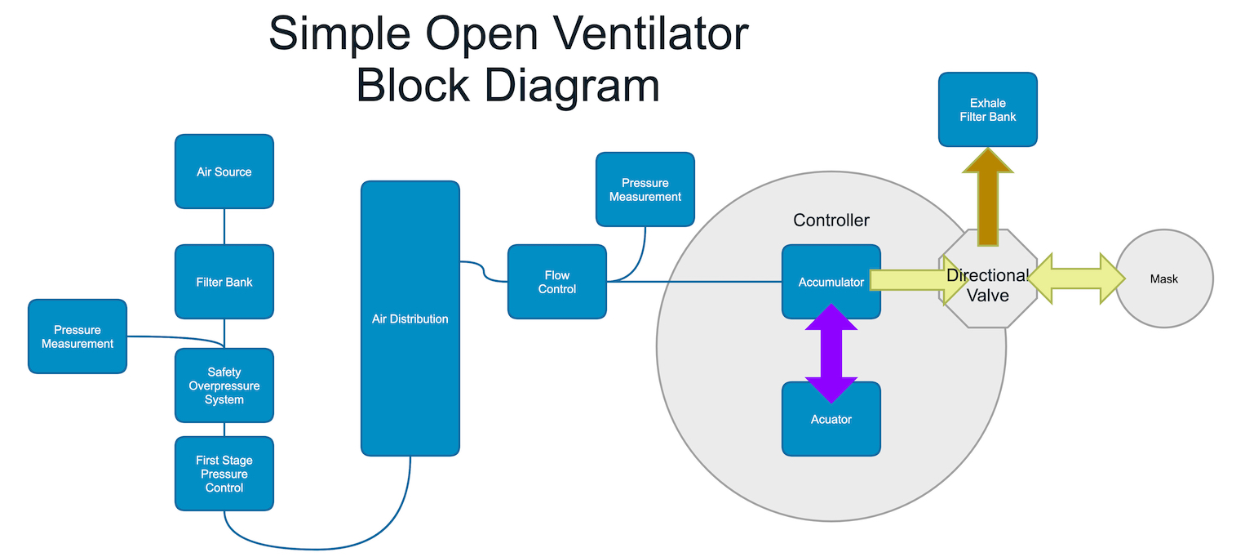
System/Images/SystemBlockDiagram.jpg
