MakerSeldon/SimpleOpenVentilator/System/ImageV1/IMG_0249 2.JPG

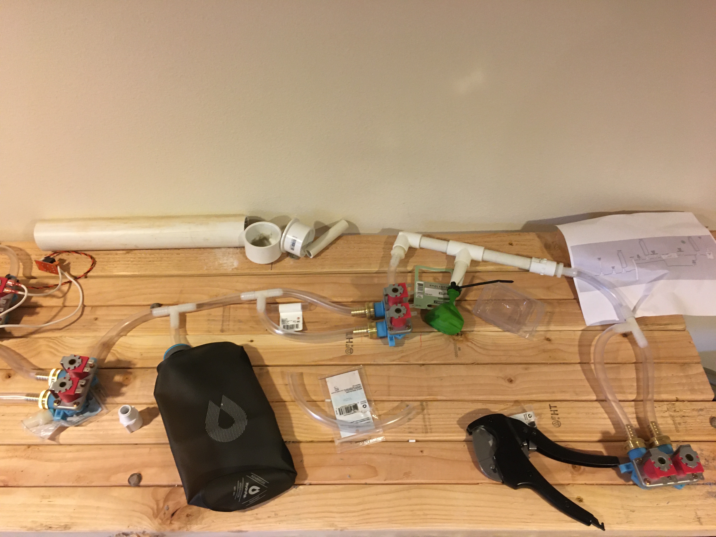
System/ImageV1/IMG_0249 2.JPG
