MakerSeldon/SimpleOpenVentilator/System/ImageV1/IMG_0250 2.JPG

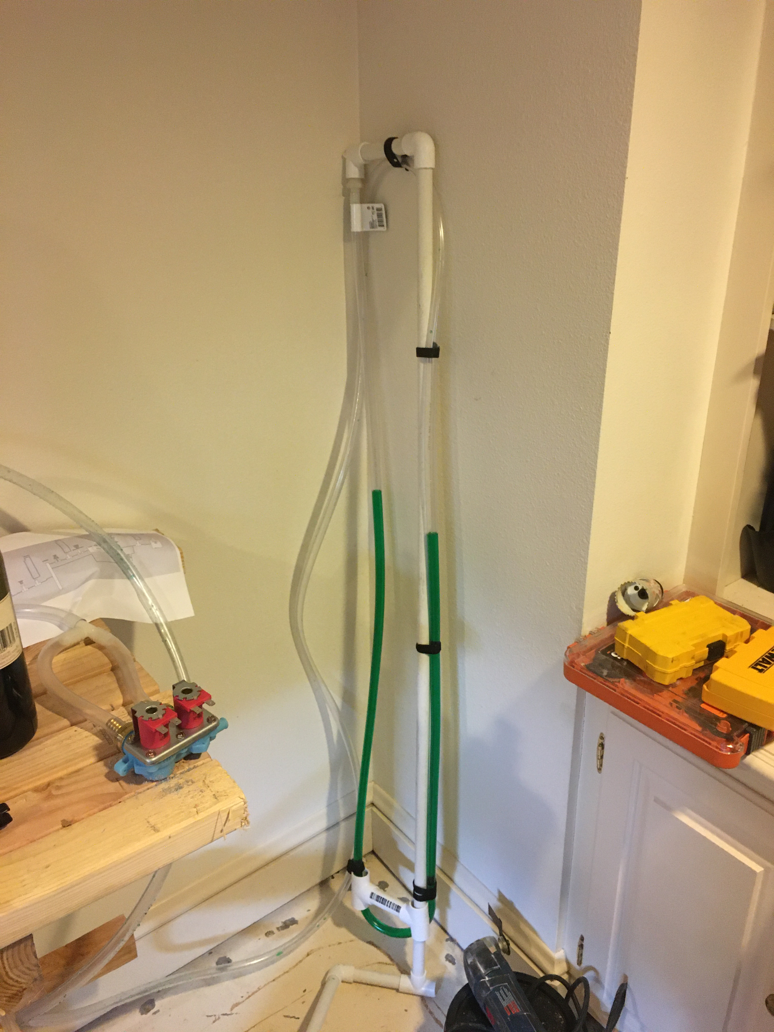
System/ImageV1/IMG_0250 2.JPG
