MakerSeldon/SimpleOpenVentilator/System/ImageV1/IMG_0251 2.JPG

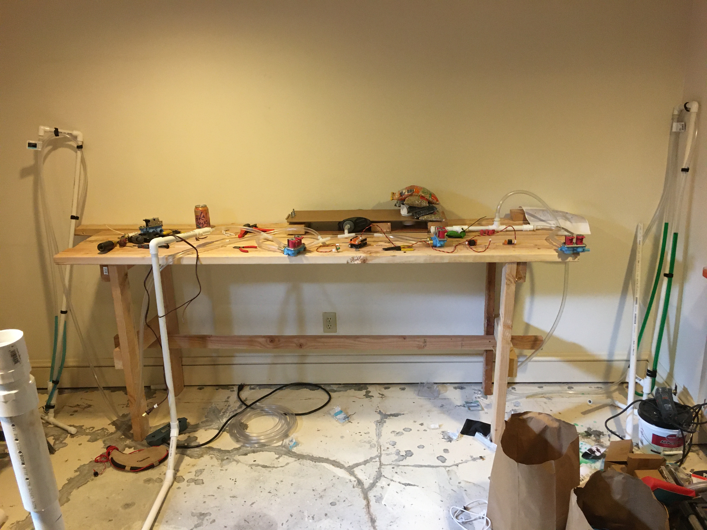
System/ImageV1/IMG_0251 2.JPG
