MakerSeldon/SimpleOpenVentilator/System/ImageV1/IMG_0256 2.JPG

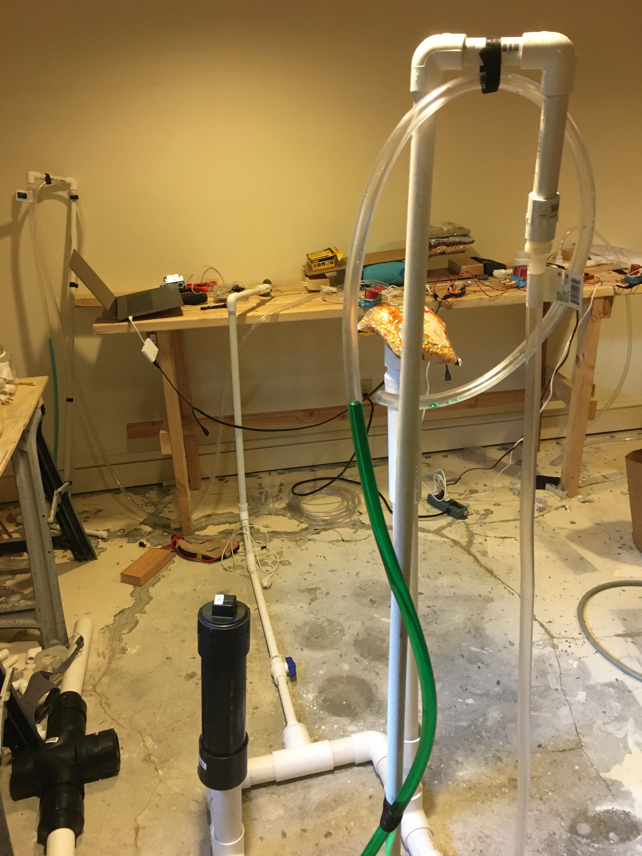
System/ImageV1/IMG_0256 2.JPG
