MakerSeldon/SimpleOpenVentilator/System/LowPressureManometer/ManometerDrawing2.jpg

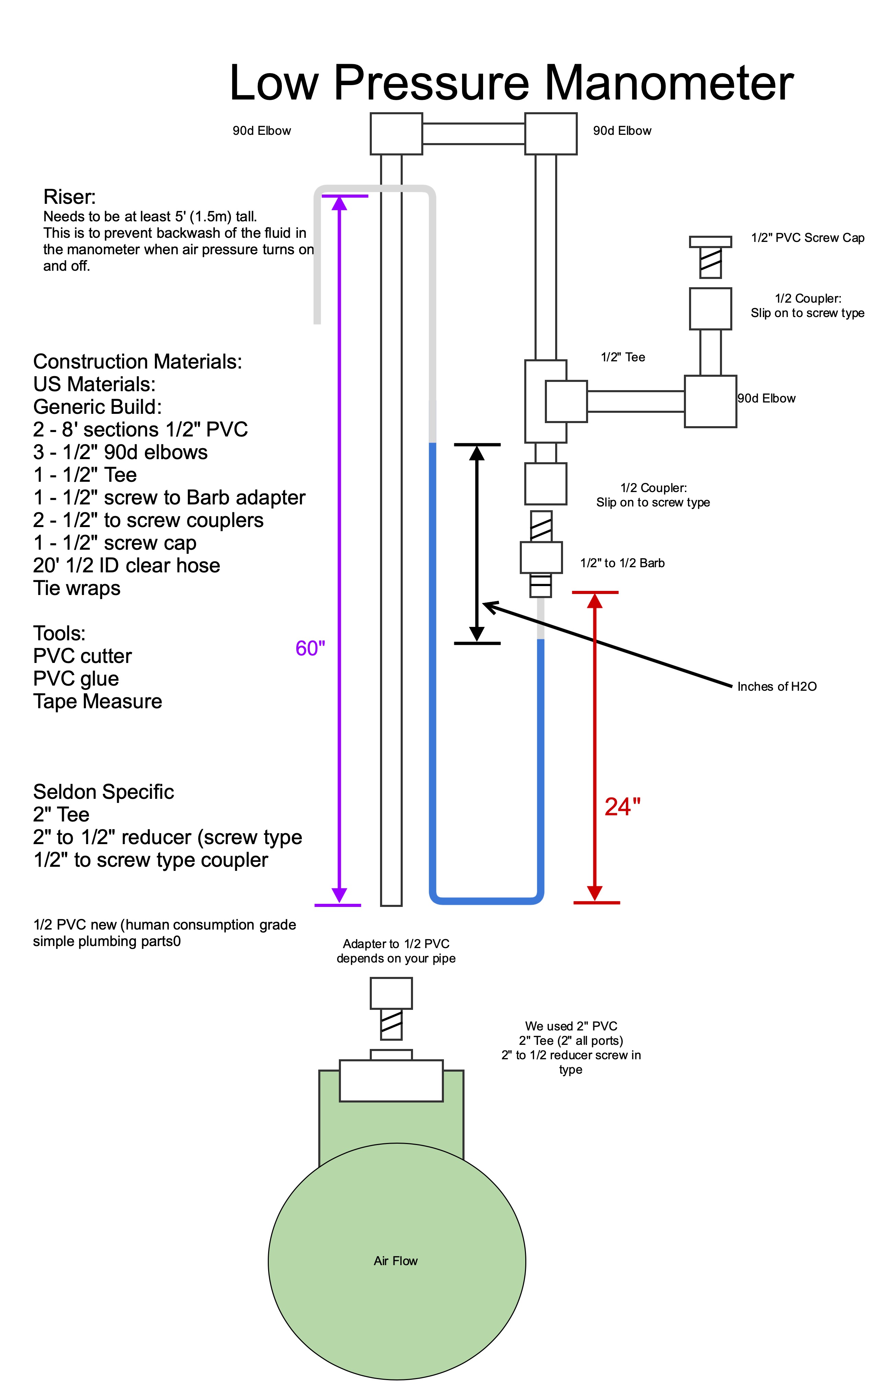
System/LowPressureManometer/ManometerDrawing2.jpg
