MakerSeldon/SimpleOpenVentilator/System/LungSimulator/LungSimDrawing.jpg

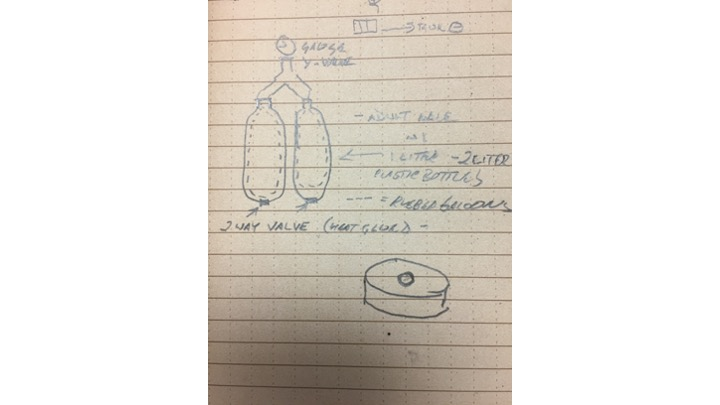
System/LungSimulator/LungSimDrawing.jpg
