MakerSeldon/SimpleOpenVentilator/System/PressureControlValve/PCVweightAssy.jpg

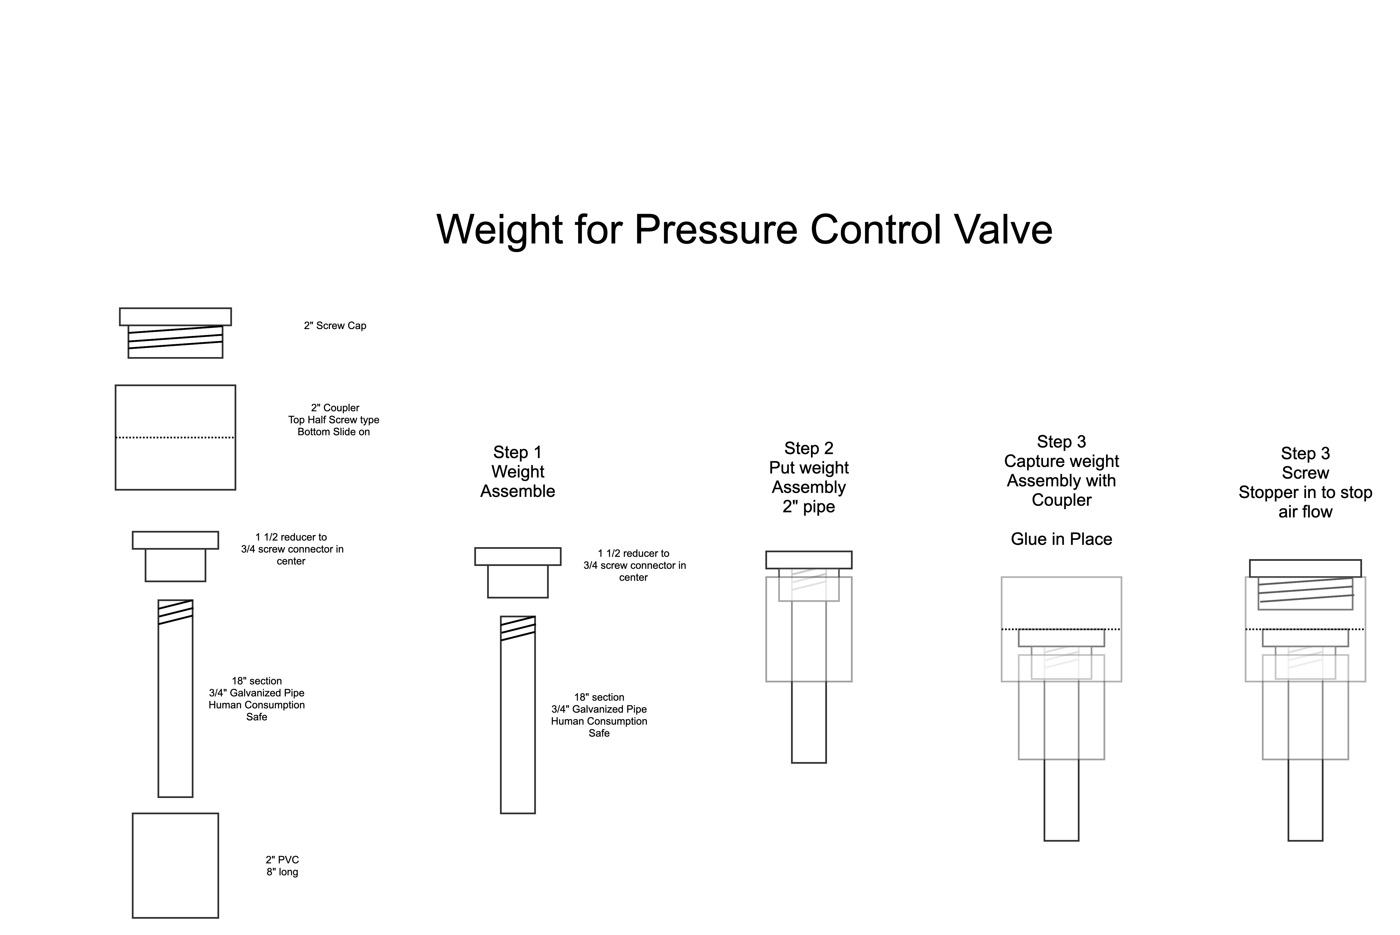
System/PressureControlValve/PCVweightAssy.jpg
