MakerSeldon/SimpleOpenVentilator/System/RawDesigns/openventsystemdiagram.jpg

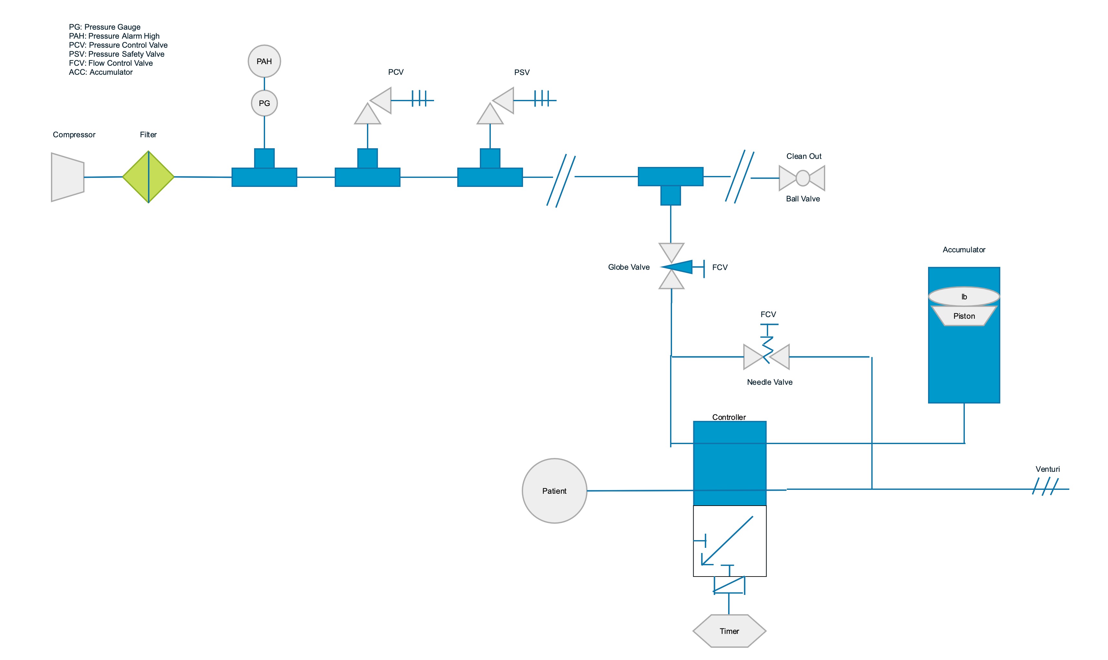
System/RawDesigns/openventsystemdiagram.jpg
