MakerSeldon/SimpleOpenVentilator/System/RawDesigns/pressurecontrolsketch.jpg

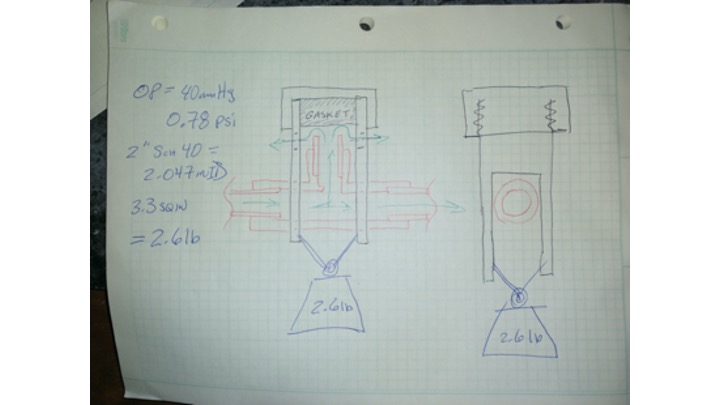
System/RawDesigns/pressurecontrolsketch.jpg
