MakerSeldon/SimpleOpenVentilator/System/RawDesigns/psv_m_drawing.jpg

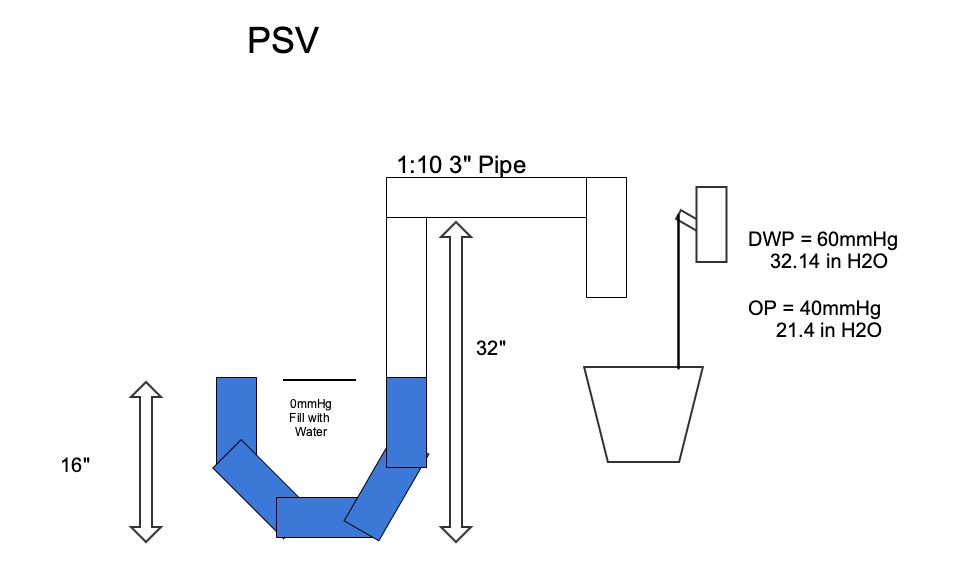
System/RawDesigns/psv_m_drawing.jpg
