MakerSeldon/SimpleOpenVentilator/System/RawDesigns/psv_m_sketch.jpg

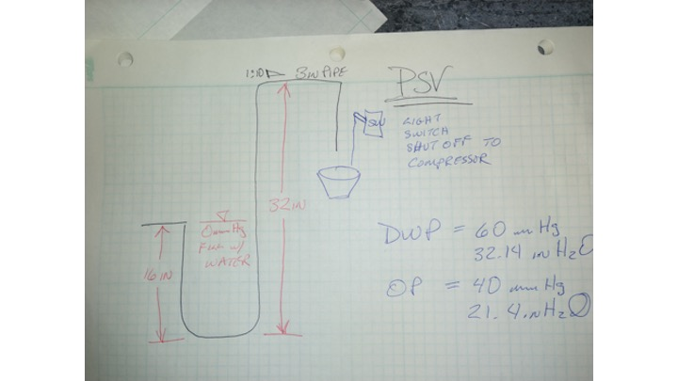
System/RawDesigns/psv_m_sketch.jpg
