MakerSeldon/SimpleOpenVentilator/System/RawDesigns/systemdesign.jpg

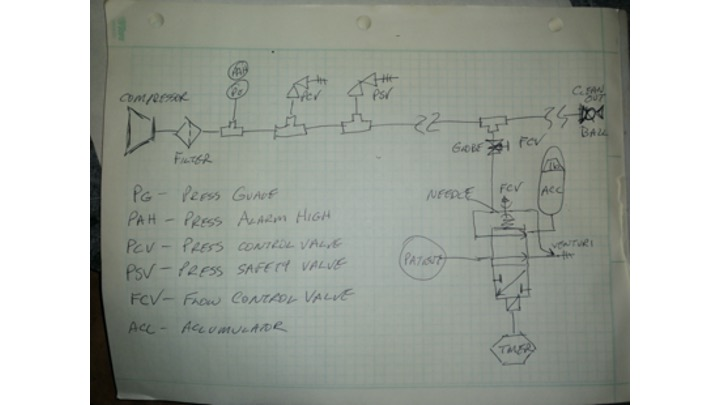
System/RawDesigns/systemdesign.jpg
