MakerSeldon/SimpleOpenVentilator/System/Sequencer/hookup.bmp

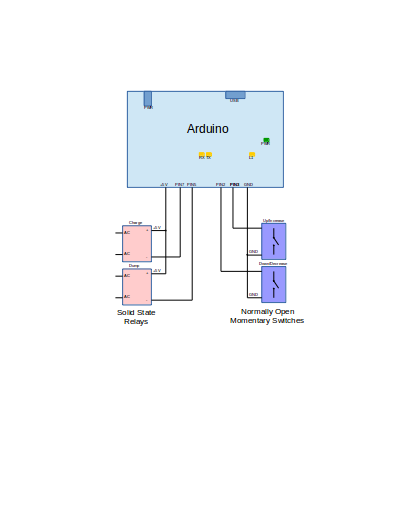
System/Sequencer/hookup.bmp
