MakerSeldon/SimpleOpenVentilator/System/Ventilator/PeepDiagram.jpg

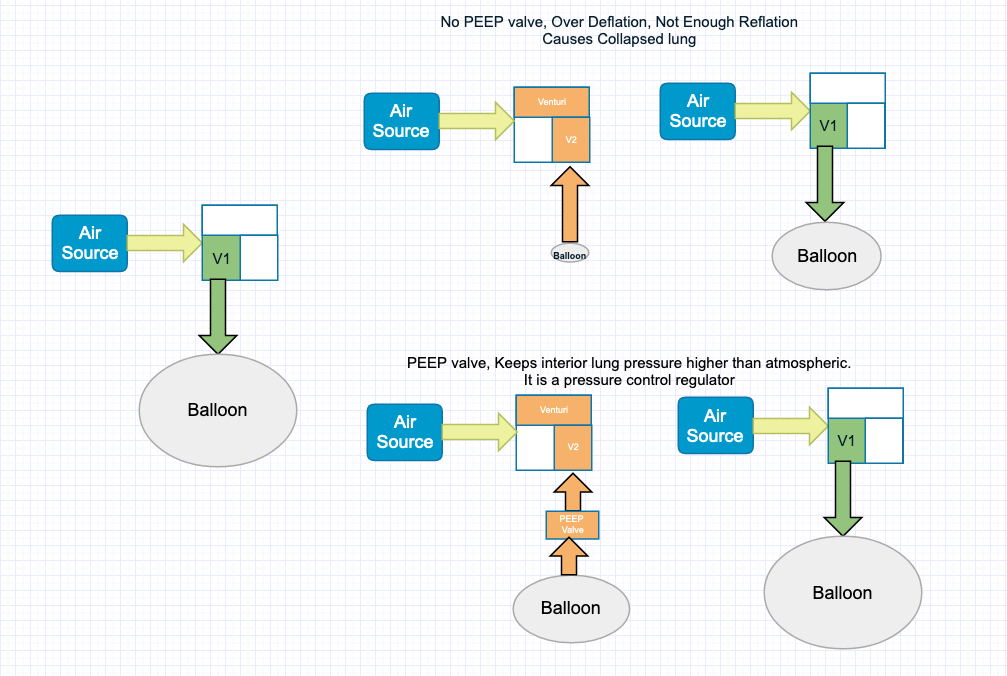
System/Ventilator/PeepDiagram.jpg
