MakerSeldon/SimpleOpenVentilator/System/AssemblyChapter/README.md

# Sub Component Parts

We have all the sub components listed here. -- for book
