MakerSeldon/SimpleOpenVentilator/System/Images/holesexperiment.JPG

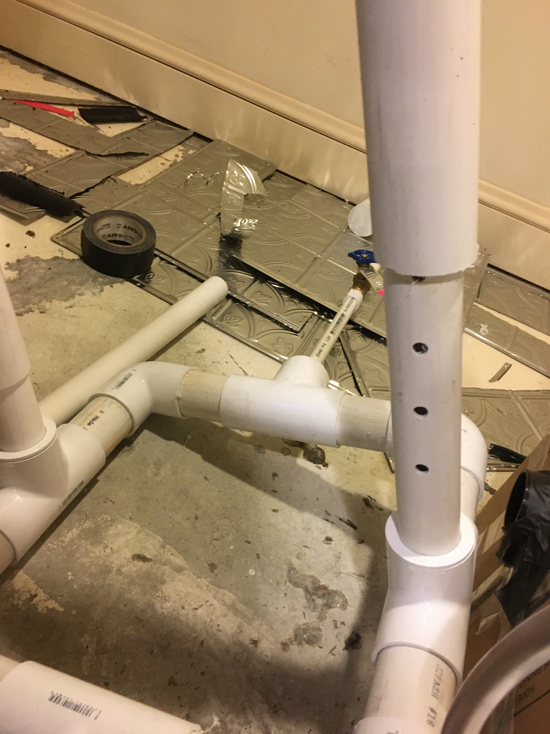
System/Images/holesexperiment.JPG
