MakerSeldon/SimpleOpenVentilator/(commit log)

2020-03-12 Create EXPERIMENT1.md
    Added Description of building a single stage filter box.
2020-03-12 Edits for Pressure Relief vs Control
2020-03-13 Documentation
    Added Front end material
    1st Partial system diagram added
2020-03-17 Added Weight Assembly
2020-03-17 Added Air Pressure Delievery
2020-03-19 added valve design page
2020-03-20 Timer Relay
2020-03-24 Updates regarding valve issues.
2020-04-02 Basic Arduino Code
2020-04-03 updated BOM, State Diagrams
    [BOMv1.xlsx]
2020-04-03 BOM added
    [BOMv1.csv, BOMv1.xlsx]
2020-04-05 Sample Arduino Code
