MakerSeldon/SimpleOpenVentilator/System/Images/IMG_0148.JPG

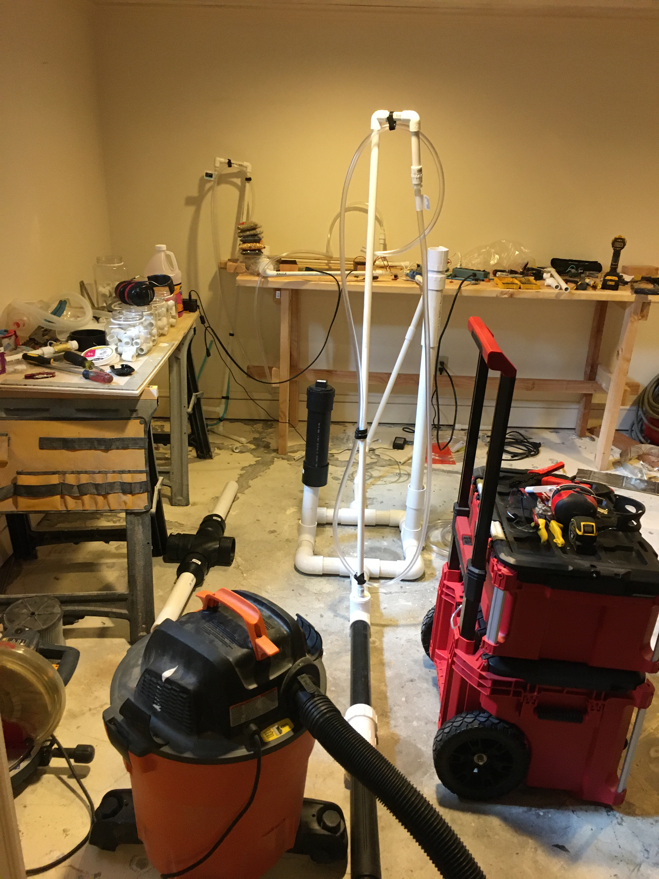
System/Images/IMG_0148.JPG
