MakerSeldon/SimpleOpenVentilator/System/Images/IMG_0167.JPG

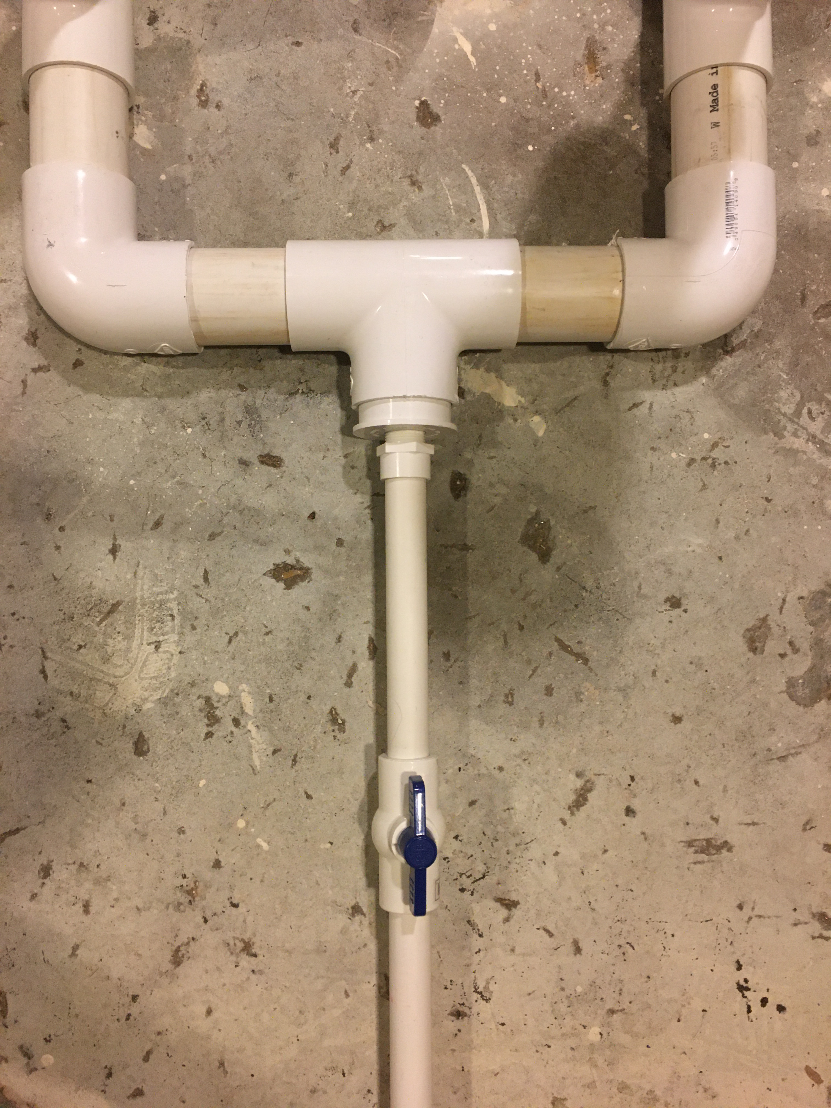
System/Images/IMG_0167.JPG
