MakerSeldon/SimpleOpenVentilator/System/Images/interiorweightexplodedview.JPG

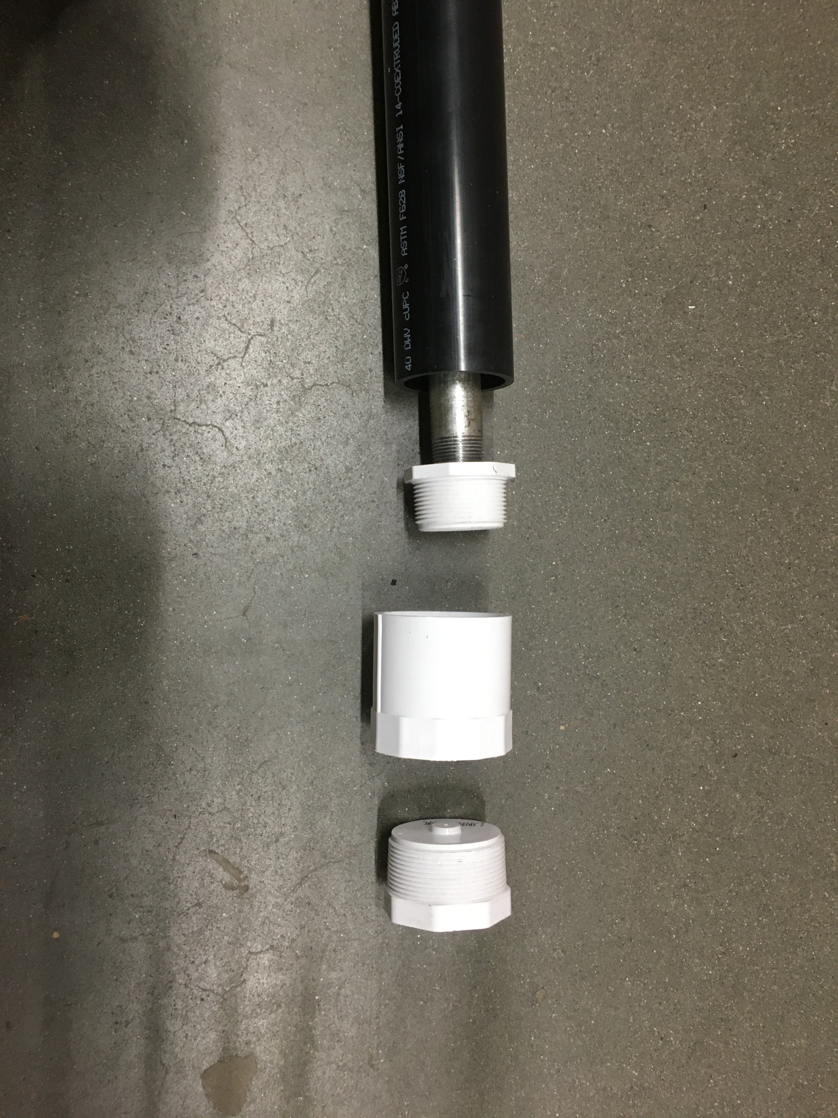
System/Images/interiorweightexplodedview.JPG
