MakerSeldon/SimpleOpenVentilator/System/Images/galv_pipe_parts.JPG

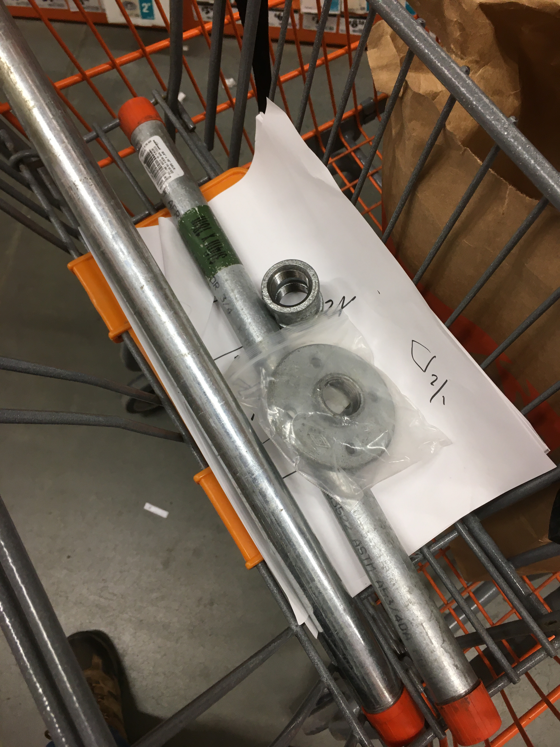
System/Images/galv_pipe_parts.JPG
